jbrryhooves/sound-compass/sch/mic-test-board/manufacturing/mic_test_board_RevA.csv

Reference | Value | Datasheet | Footprint | Qty | DNP | EXCLUDE_FROM_BOM | Manufacturer | Part Number | Supplier | Supplier Number | Voltage
C1 C3 C5 C7 C9 C12 C15 C19 C24 C59-C64 C67 C69 C71 C73 C75 C79 C81 | 1uF | ~ | Capacitor_SMD:C_0603_1608Metric | 22 | -- mixed values -- |  | YAGEO | CC0603KRX7R7BB105 | Digi-Key | 311-1446-1-ND | 16V
C2 C4 C6 C8 C10 C11 C13 C14 C17 C21-C23 C25 C68 C70 C72 C74 C76 C78 C80 C82 C83 C201 C208-C211 | 0.1uF | ~ | Capacitor_SMD:C_0603_1608Metric | 27 |  |  | YAGEO | CC0603KRX7R7BB104 | Digi-Key | 311-1088-1-ND | 16V
C16 C77 | 10uF | ~ | Capacitor_SMD:C_0805_2012Metric | 2 |  |  | Samsung Electro-Mechanics | CL21B106KOQNNNE | Digi-Key | 1276-2872-1-ND | 16V
C18 C20 C26 C27 C29 C30 C33 C35 C36 C39 C41 C42 C45 C47 C48 C51 C53 C54 C57 C65 C66 C86 C88 C89 C92 C94 C95 C98 C100 C101 C104 C106 C107 C110 C112 C113 C116 C118 C119 C122 C124 C125 C128 C130 C131 C134 C186 C187 | 10nF | ~ | Capacitor_SMD:C_0603_1608Metric | 48 |  |  | KEMET | C0603C103M4RAC7867 | Digi-Key | 399-C0603C103M4RAC7867CT-ND | 16V
D1-D10 | LED_Small_Filled | ~ | LED_SMD:LED_0805_2012Metric | 10 |  |  | Lumex Opto/Components Inc. | SML-LX0805SRC-TR | Digi-Key | 67-2191-1-ND
D11 | SMBJ5340BE3/TR13 | https://www.microsemi.com/document-portal/doc_download/124875-lds-0246-2-datasheet | Diode_SMD:D_SMB | 1 |  |  | Microchip Technology | SMBJ5340BE3/TR13 | Digi-Key | 150-SMBJ5340BE3/TR13CT-ND | 6V
J1 J5 | -- mixed values -- | ~ | ~ | 2 |  |  | Sullins Connector Solutions | GEC36DFBN-M30 | Digi-Key | S2341E-36-ND
J3 | Conn_01x02 | ~ | Connector_PinHeader_2.54mm:PinHeader_1x02_P2.54mm_Vertical | 1
J4 | Conn_01x02 | ~ | TerminalBlock_Phoenix:TerminalBlock_Phoenix_MKDS-1,5-2_1x02_P5.00mm_Horizontal | 1 |  |  | Phoenix Contact | 1715022 | Digi-Key | 277-1258-ND
J6 | CN11.male | ~ | ~ | 1 |  |  | Sullins Connector Solutions | PPTC042LFBN-RC | Digi-Key | S7072-ND
J7-J9 J11 J13 J15 J17 J19 J21 J23 J25 J27 J29 J31 J33 J35 | Conn_01x05 | https://www.molex.com/pdm_docs/sd/530470510_sd.pdf | mic-test-board:Molex_PicoBlade_53047-0510_1x05_P1.25mm_Vertical | 16 |  |  | Molex | 0530470510 | Digi-Key | WM1734-ND
J10 J14 J16 J18 J20 J22 J24 J26 J28 J30 J32 J34 J36-J38 P1 | Mating pre-crimped connector, 300mm | https://www.literature.molex.com/SQLImages/kelmscott/Molex/PDF_Images/987651-5322.PDF | ~ | 16 |  |  | Molex | 0151340503 | Digi-Key | WM15263-ND
J12 | CN12.male | ~ | ~ | 1 |  |  | Sullins Connector Solutions | PPPC362LFBN-RC | Digi-Key | S7139-ND
R1 R40 | 49.9R | ~ | Resistor_SMD:R_0603_1608Metric | 2 |  |  | Panasonic Electronic Components | ERJ-3EKF49R9V | Digi-Key | P49.9HCT-ND
R2 R3 R8 R14 R20 R26-R28 R32 R35 R37-R39 R45 R53 R59 R65 R71 R77 R83 R89 R95 R101 R118-R120 R238 | 0R | ~ | Resistor_SMD:R_0603_1608Metric | 27 | -- mixed values -- |  | Stackpole Electronics Inc | RMCF0603ZT0R00 | Digi-Key | RMCF0603ZT0R00CT-ND
R4 R33 R135-R142 | 470R | ~ | Resistor_SMD:R_0603_1608Metric | 10 |  |  | YAGEO | RC0603JR-07470RL | Digi-Key | 311-470GRCT-ND
R5-R7 R9 R12 R15 R18 R21 R24 R30 R43 R46 R49 R54 R57 R60 R63 R66 R69 R72 R75 R78 R81 R84 R87 R90 R93 R96 R99 R102 R105 R223 | 33R | ~ | Resistor_SMD:R_0603_1608Metric | 32 |  |  | Vishay Dale | CRCW060333R0FKEAC | Digi-Key | 541-3988-1-ND
R10 R11 R13 R29 R31 R34 R36 | 100k | ~ | Resistor_SMD:R_0603_1608Metric | 7 | -- mixed values -- |  | YAGEO | RC0603FR-07100KL | Digi-Key | 311-100KHRCT-ND
SW1 SW2 | SW_Push | ~ | Button_Switch_SMD:SW_SPST_CK_RS282G05A3 | 2 |  |  | C&K | RS-282G05A3-SM RT | Digi-Key | CKN10384CT-ND
TP118-TP121 | -- mixed values -- | ~ | TestPoint:TestPoint_Keystone_5019_Minature | 4 |  |  | Keystone Electronics | 5019 | Digi-Key | 36-5019CT-ND
U1 | LMK1C1102 | https://www.ti.com/lit/ds/symlink/lmk1c1104.pdf | Package_SON:WSON-8-1EP_2x2mm_P0.5mm_EP0.9x1.6mm | 1 |  |  | Texas Instruments | LMK1C1102DQFR | Digi-Key | 296-LMK1C1102DQFRCT-ND
U2 U6 | AD7768BSTZ | https://www.analog.com/media/en/technical-documentation/data-sheets/ad7768-7768-4.pdf | Package_QFP:LQFP-64_10x10mm_P0.5mm | 2 |  |  | Analog Devices Inc. | AD7768BSTZ | Digi-Key | 505-AD7768BSTZ-ND
U3 | MAX6070BAUT33+T | https://www.analog.com/media/en/technical-documentation/data-sheets/max6070-max6071.pdf | Package_TO_SOT_SMD:SOT-23-6 | 1 |  |  | Analog Devices Inc./Maxim Integrated | MAX6070BAUT33+T | Digi-Key | MAX6070BAUT33+TCT-ND
U22 | LP5912-5.0DRV | http://www.ti.com/lit/ds/symlink/lp5912.pdf | Package_SON:WSON-6-1EP_2x2mm_P0.65mm_EP1x1.6mm_ThermalVias | 1 |  |  | Texas Instruments | LP5912-5.0DRVR | Digi-Key | 296-53182-1-ND
U23 U24 | LP5912-3.3DRV | http://www.ti.com/lit/ds/symlink/lp5912.pdf | Package_SON:WSON-6-1EP_2x2mm_P0.65mm_EP1x1.6mm_ThermalVias | 2 | -- mixed values -- |  | -- mixed values -- | LP5912-3.3DRVR | Digi-Key | 296-47214-1-ND
U34 | SN74LVC126ARGYR | https://www.ti.com/lit/ds/symlink/sn74lvc126a.pdf | mic-test-board:IC_SN74AUC08RGYRG4 | 1 |  |  | Texas Instruments | SN74LVC126ARGYR | Digi-Key | 296-13962-1-ND
X1 | KC3225Z32.7680C1KX00 | https://mm.digikey.com/Volume0/opasdata/d220001/medias/docus/204/KC3225Z_Series_Spec_Prelim.pdf | Oscillator:Oscillator_SMD_SeikoEpson_SG210-4Pin_2.5x2.0mm | 1 |  |  | KYOCERA AVX | KC3225Z32.7680C1KX00 | Digi-Key | 478-KC3225Z32.7680C1KX00CT-ND
