jbrryhooves/sound-compass/calc/TestPCBCalcs.xlsx

ADC
Preamp LP filter
Common mode filter
R | 33
C | 4.7e-08
Fc | 102614.4056 | Hz
R | 4000
C | 4.7e-10
Fc | 84656.88462 | Hz
Input differential 1st order HP filter
R | 200000 | Ohm | Input impedance of the THS4531AIRUNR opamp
C | 1e-07 | F | Input DC blocking cap
Fc | 7.957747155 | Hz
