jbrryhooves/sound-compass/sch/mic-test-board/mic-test-pcb 3D v250321.pdf

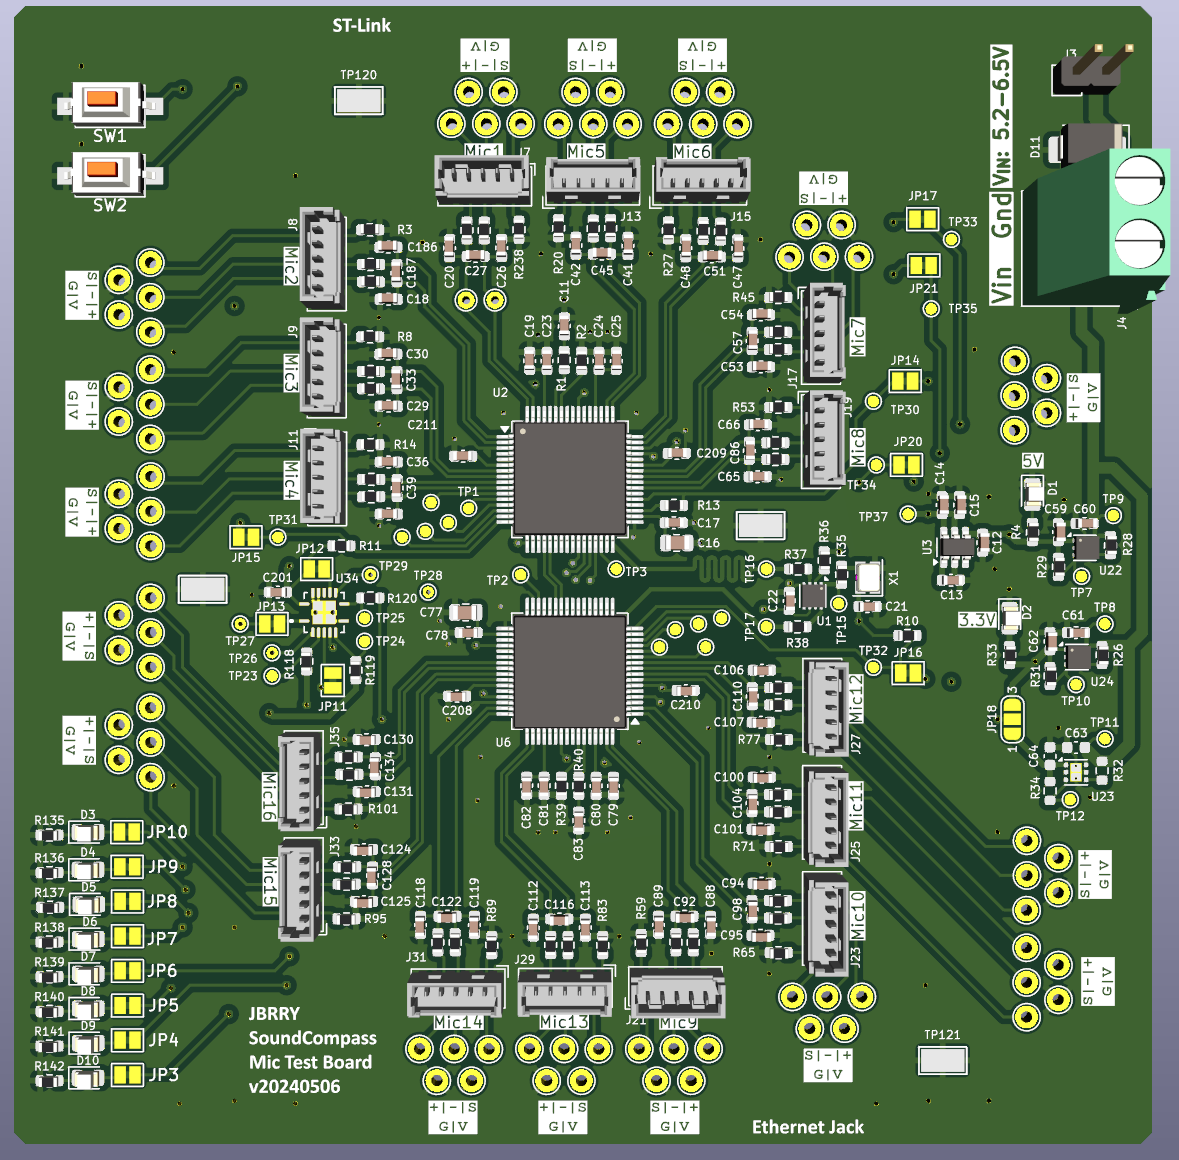
[picture p1: figure]

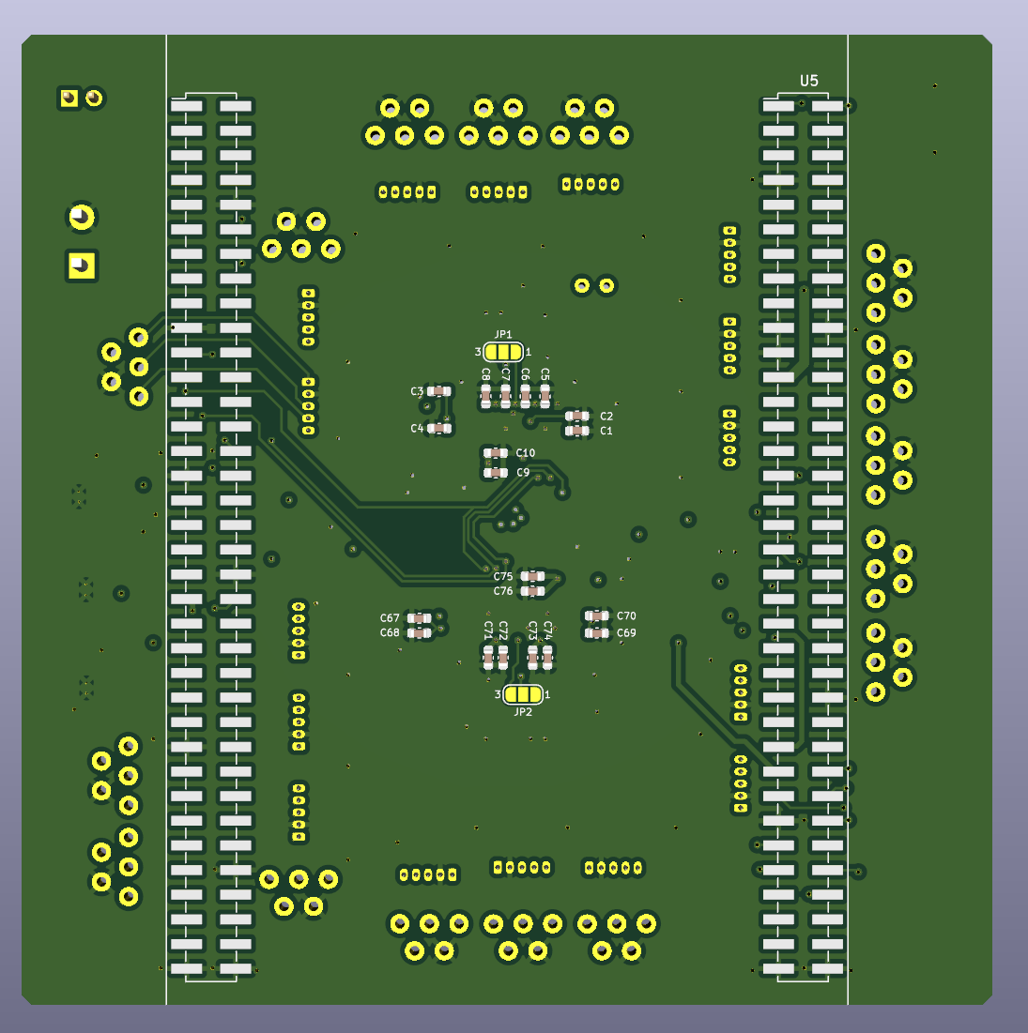
[picture p2: figure]

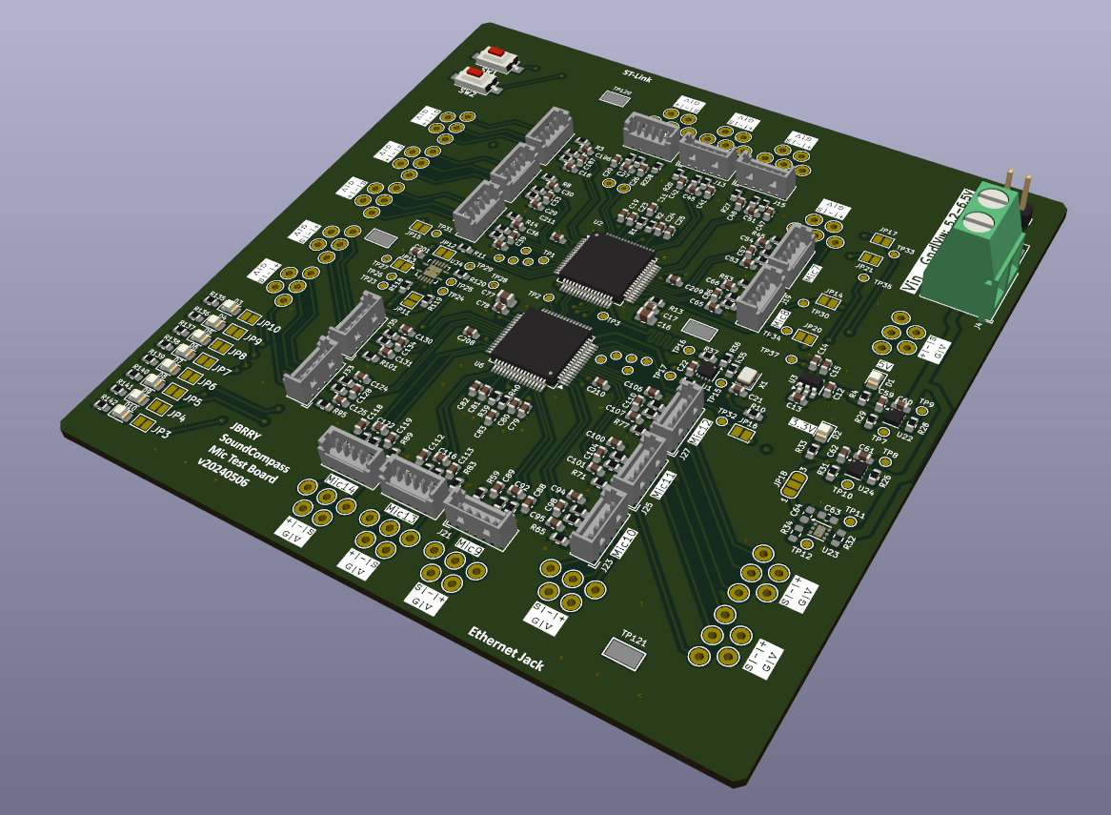
[picture p3: figure]
