jbrryhooves/sound-compass/sch/mic-test-board/mic-test-pcb v250321.pdf

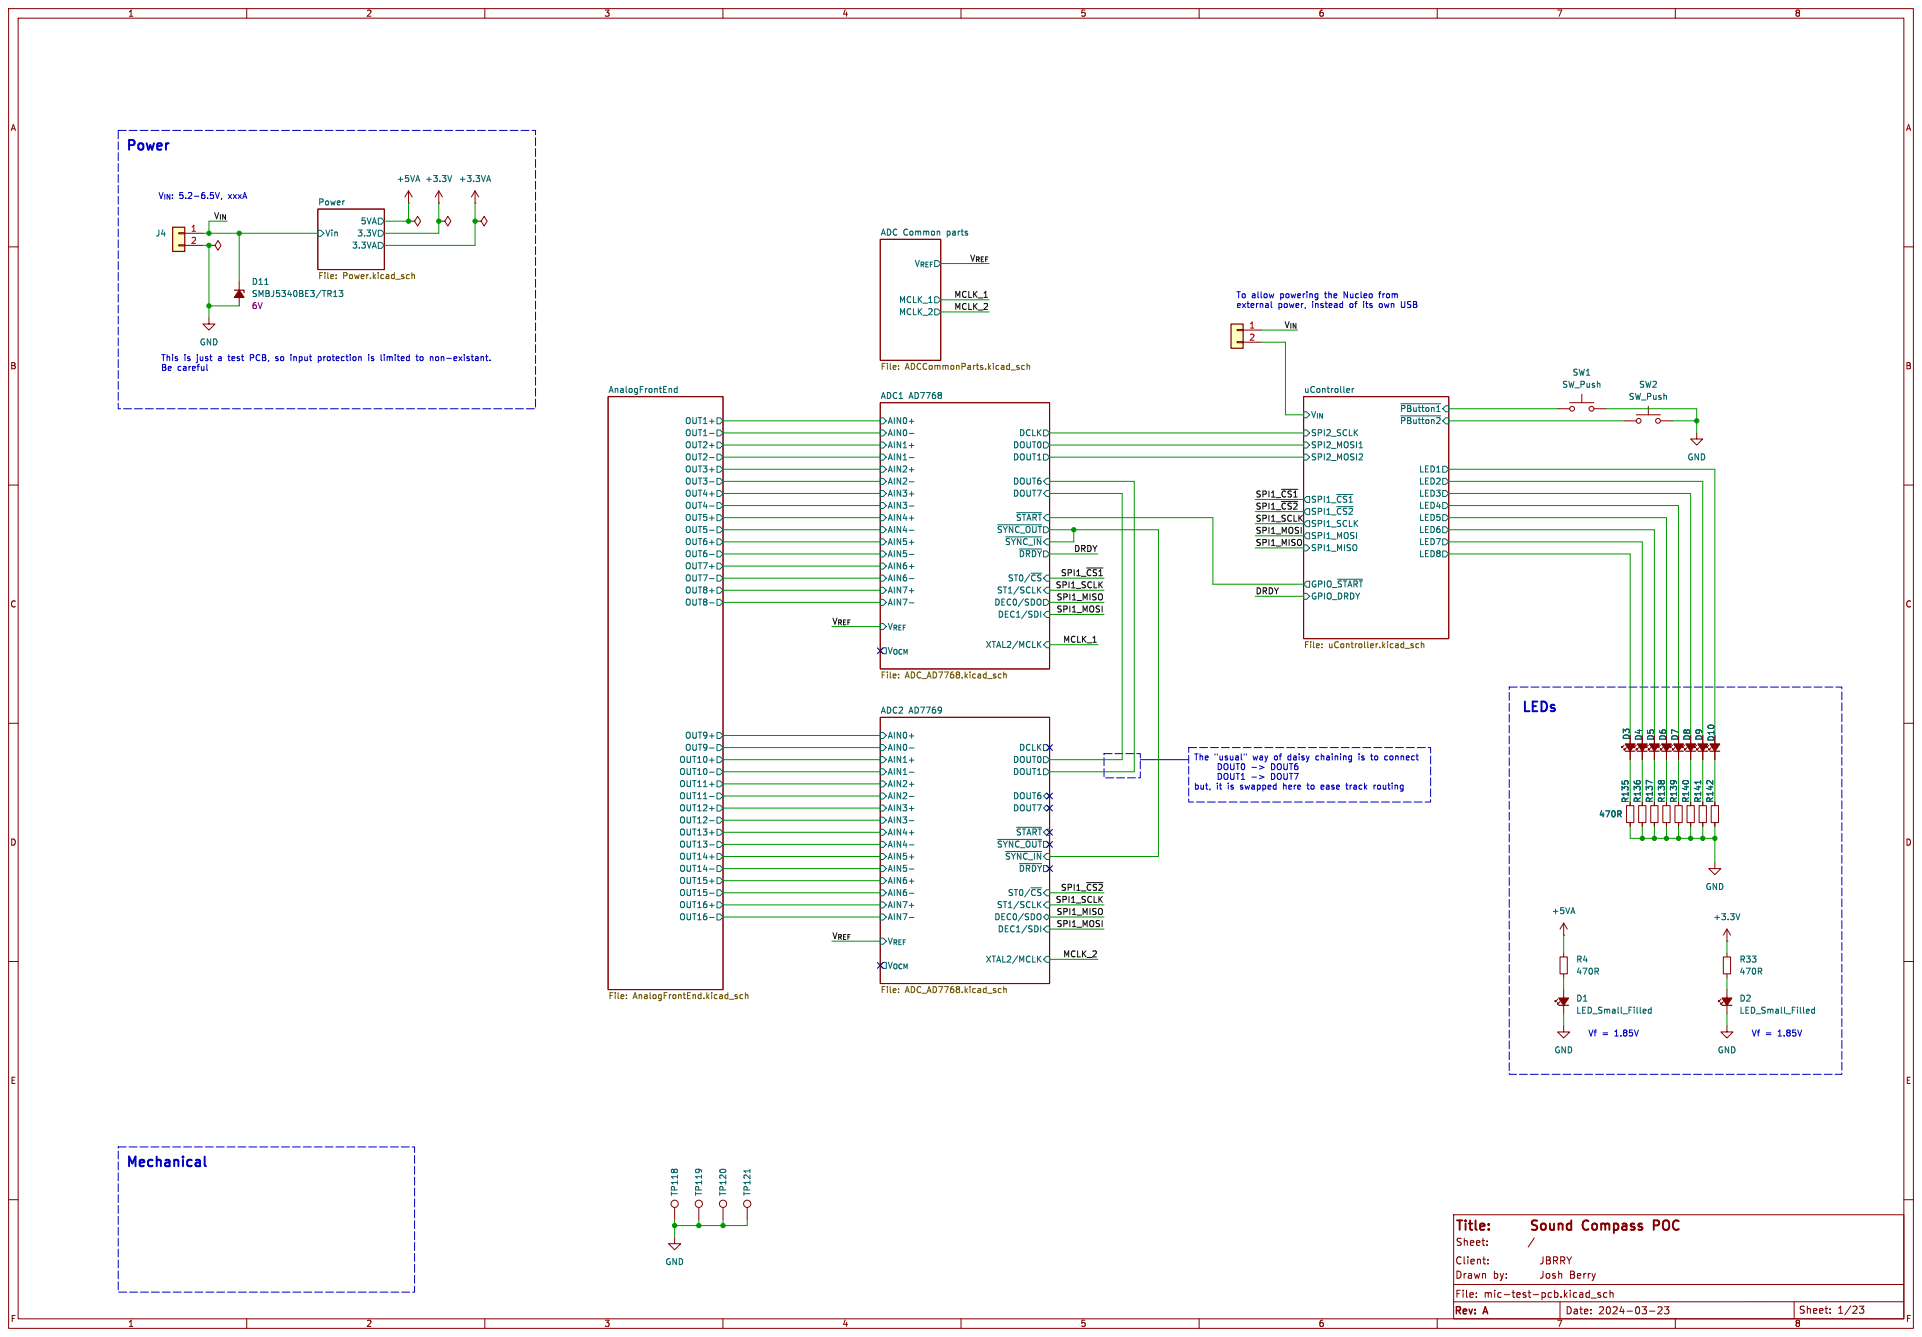
[picture p4: page 1]

To allow powering the Nucleo from

~{DRDY} DOUT1 DCLK DOUT0 DOUT6 DOUT7 ST0/~{CS} ST1/SCLK DEC0/SDO

DEC1/SDI V_{OCM} ADC2 AD7769 File: ADC_AD7768.kicad_sch OUT15+ OUT15- OUT16+ OUT16- OUT11- OUT11+ OUT12- OUT10- OUT12+ OUT14- OUT14+ OUT13- OUT13+ OUT10+ OUT9+ OUT9- OUT1+ OUT1- OUT4+ OUT4- OUT3+ OUT3- OUT7+ OUT5- OUT5+ OUT6+ OUT6- OUT8+ OUT7- OUT8- OUT2+ OUT2- AnalogFrontEnd

but, it is swapped here to ease track routing

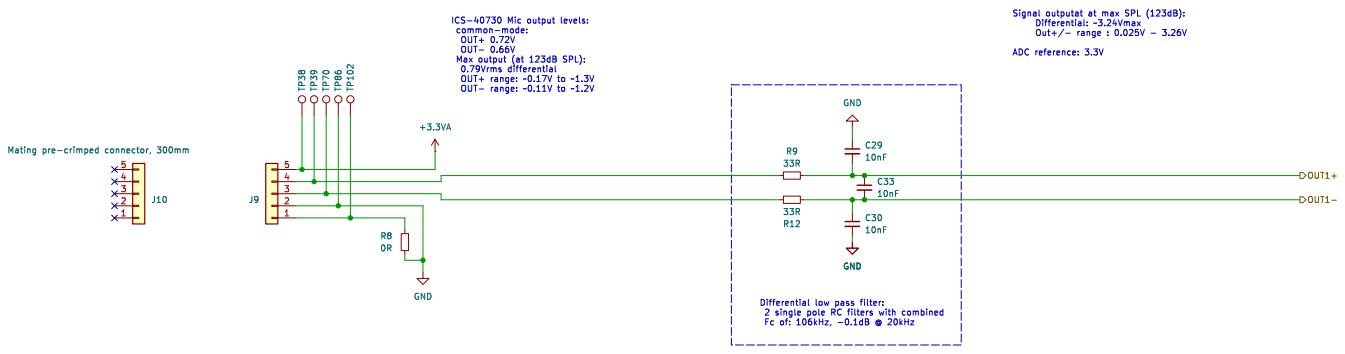
[picture p5: page 2]

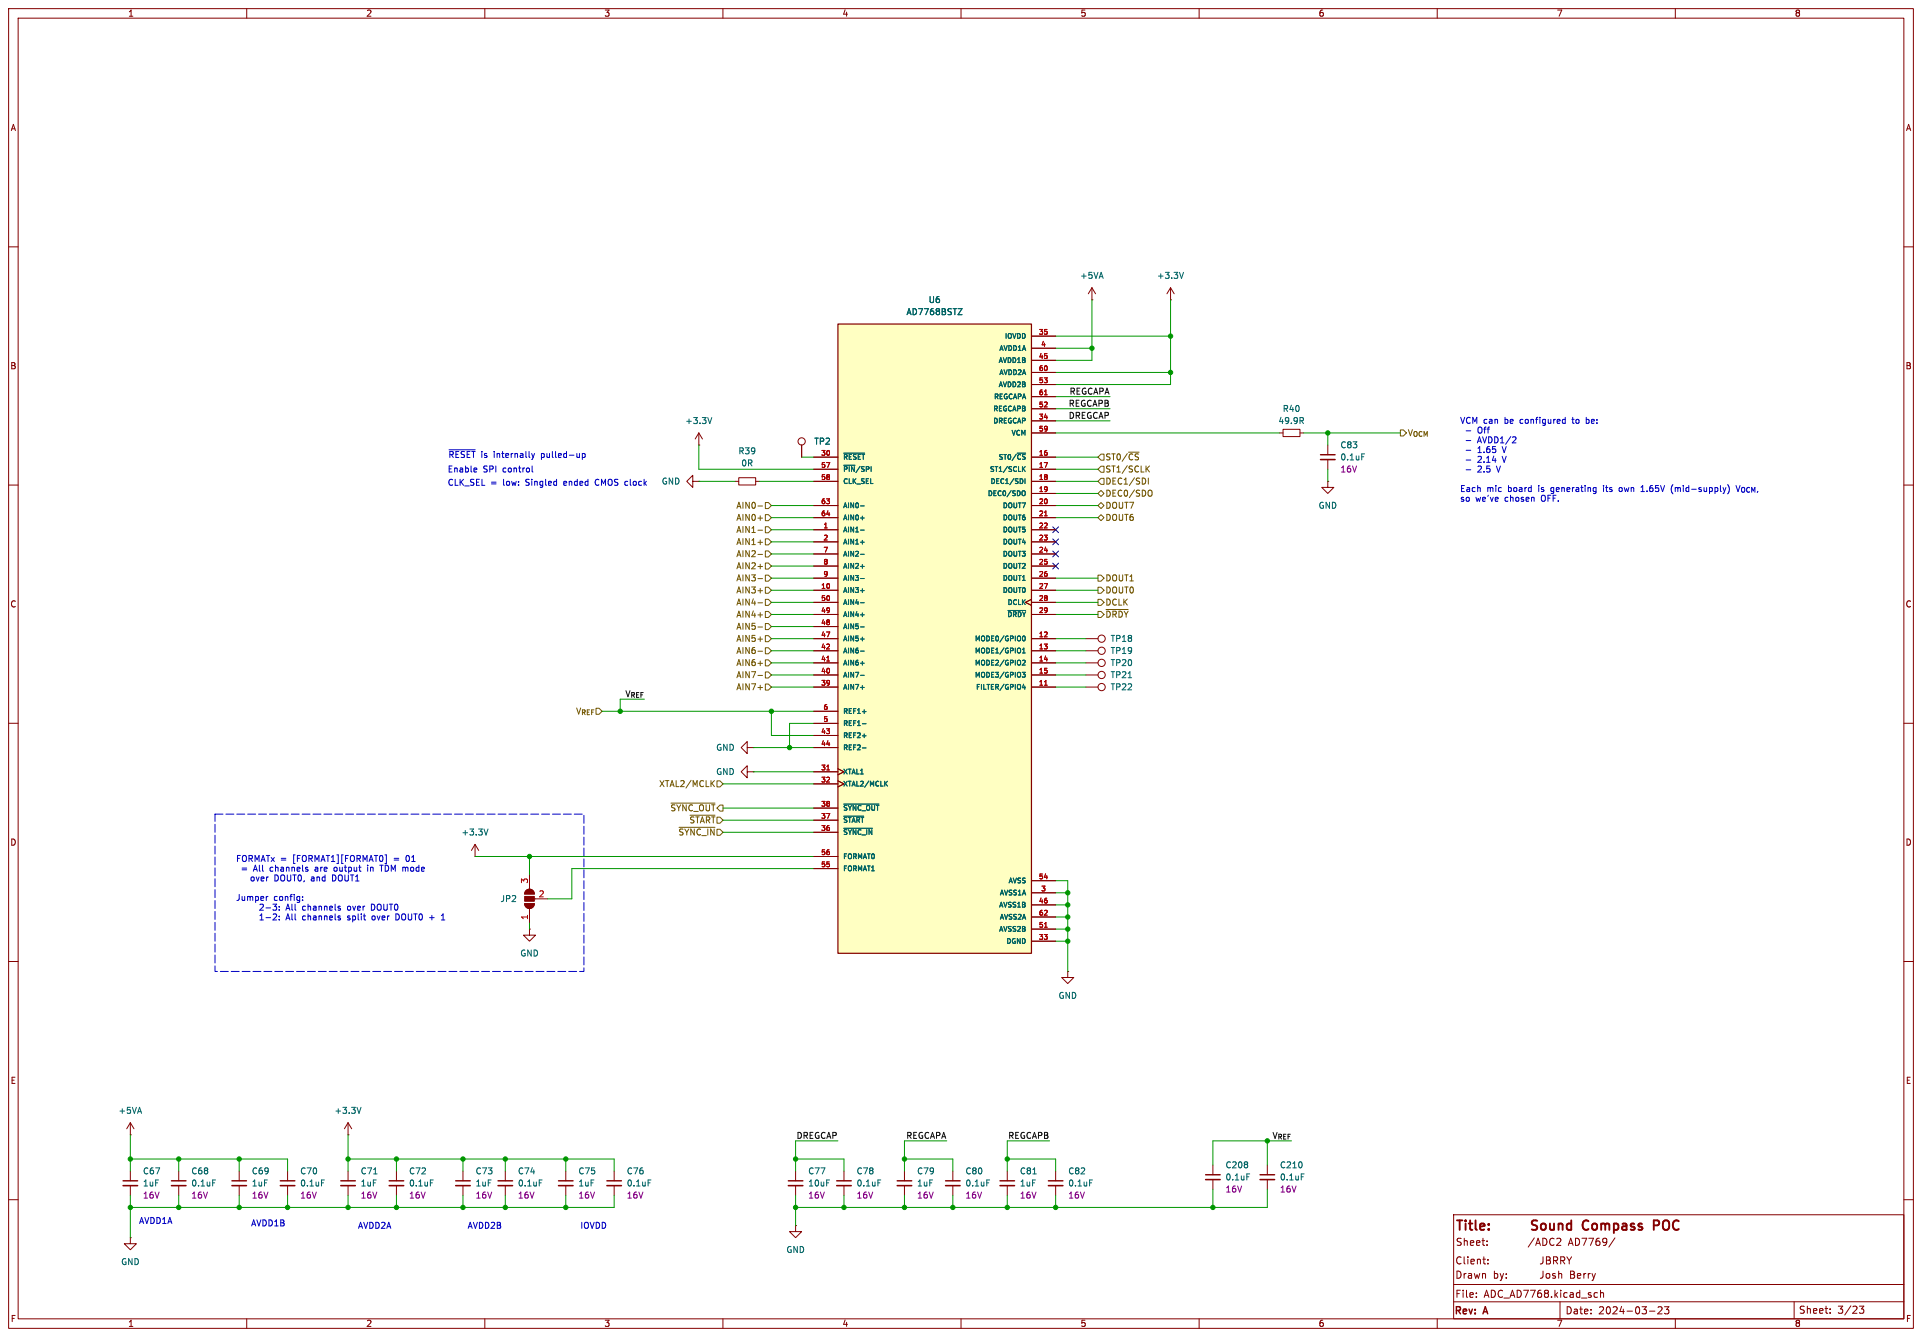
[picture p6: page 3]

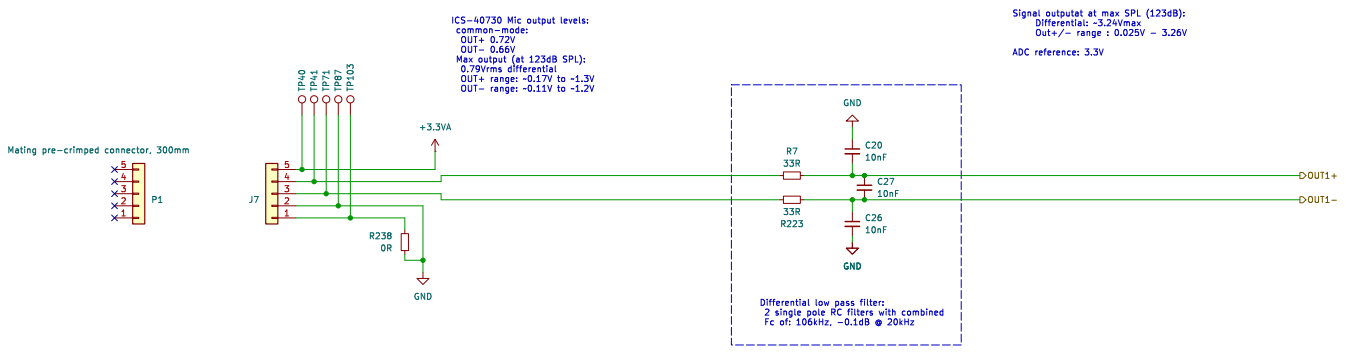
[picture p7: page 4]

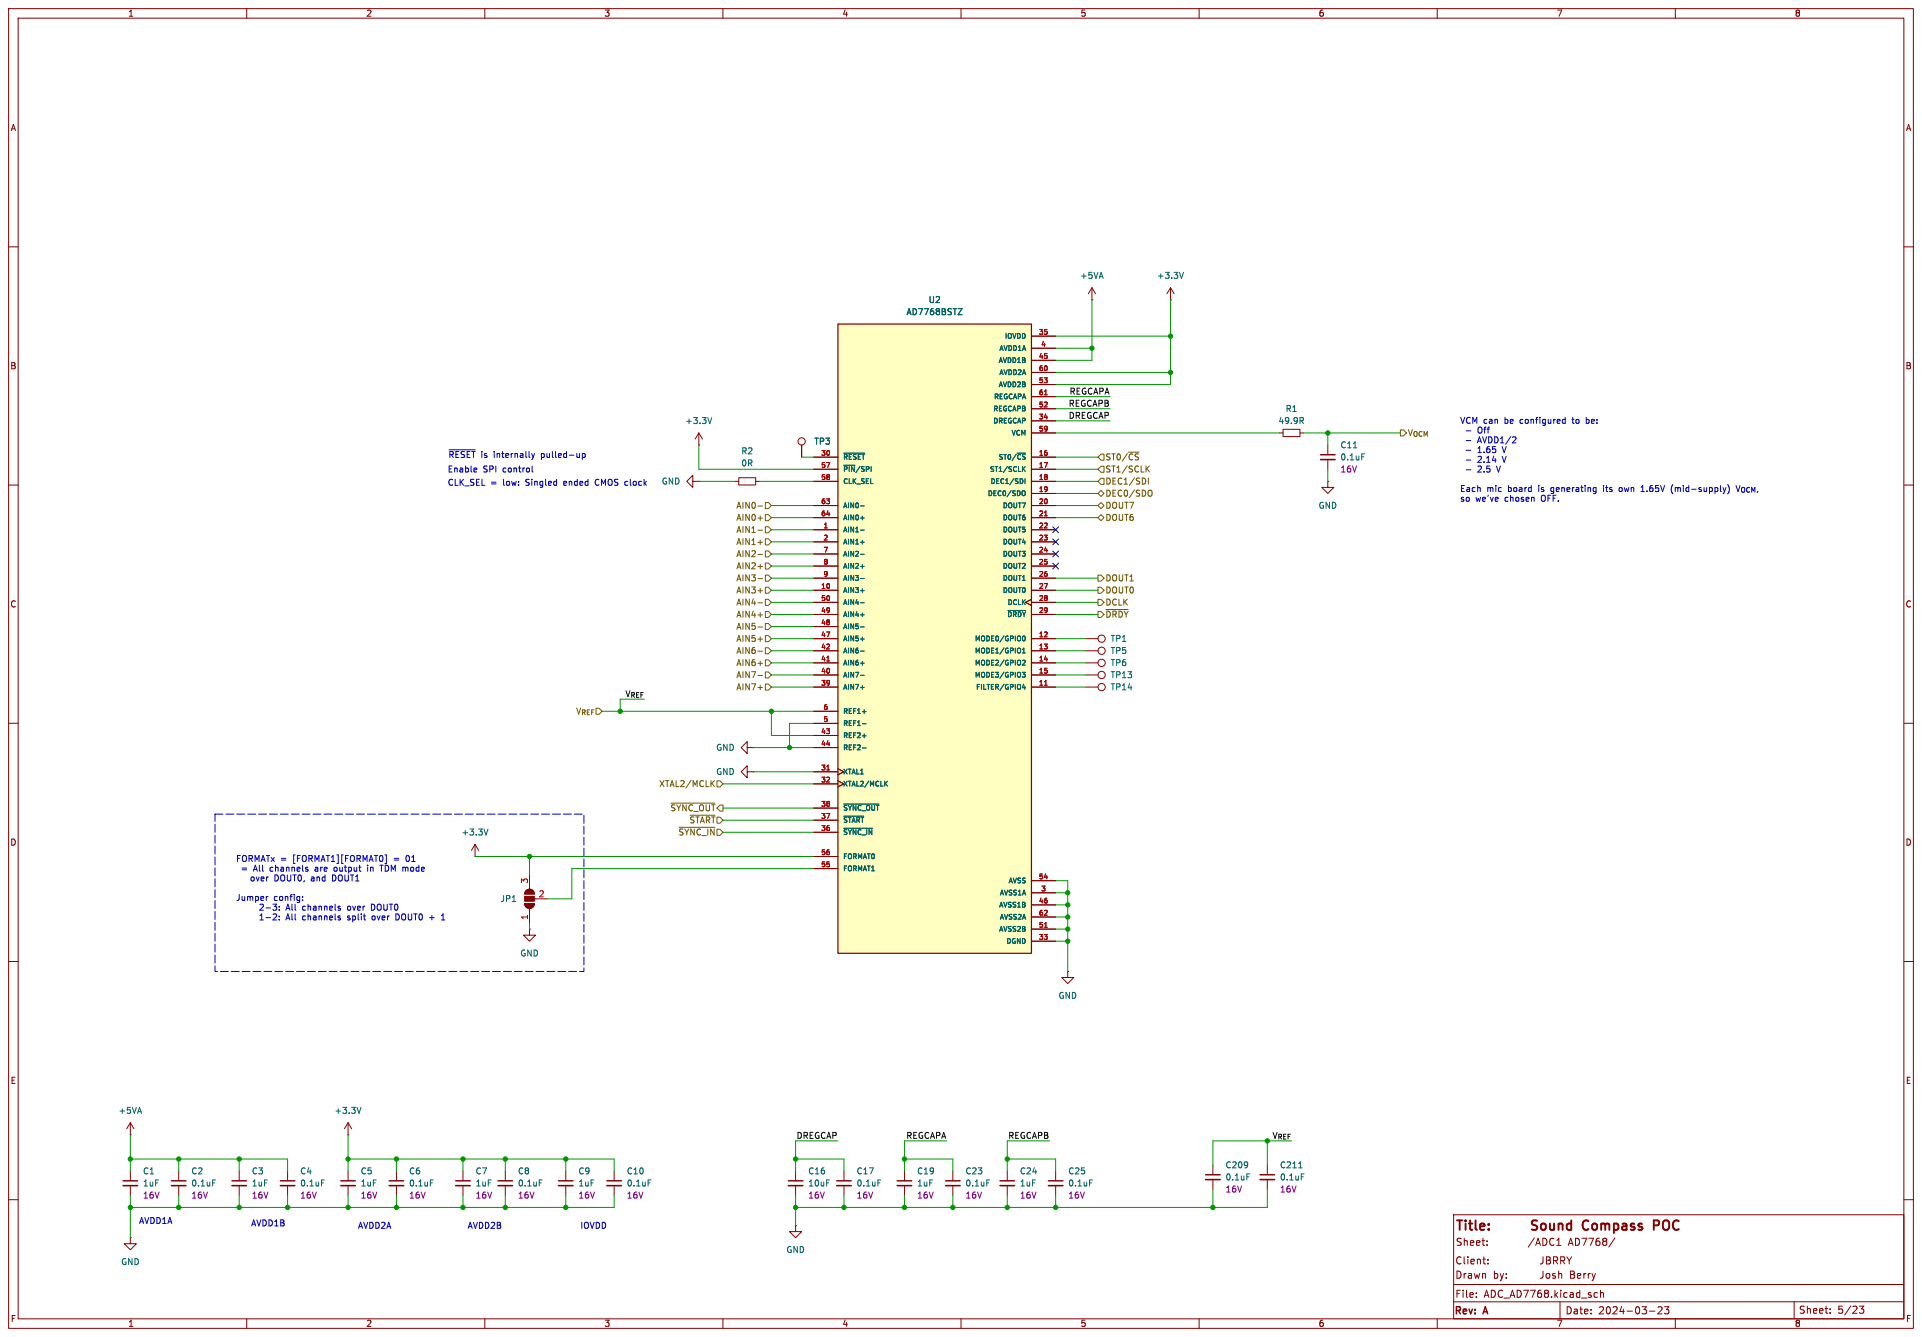
[picture p8: page 5]

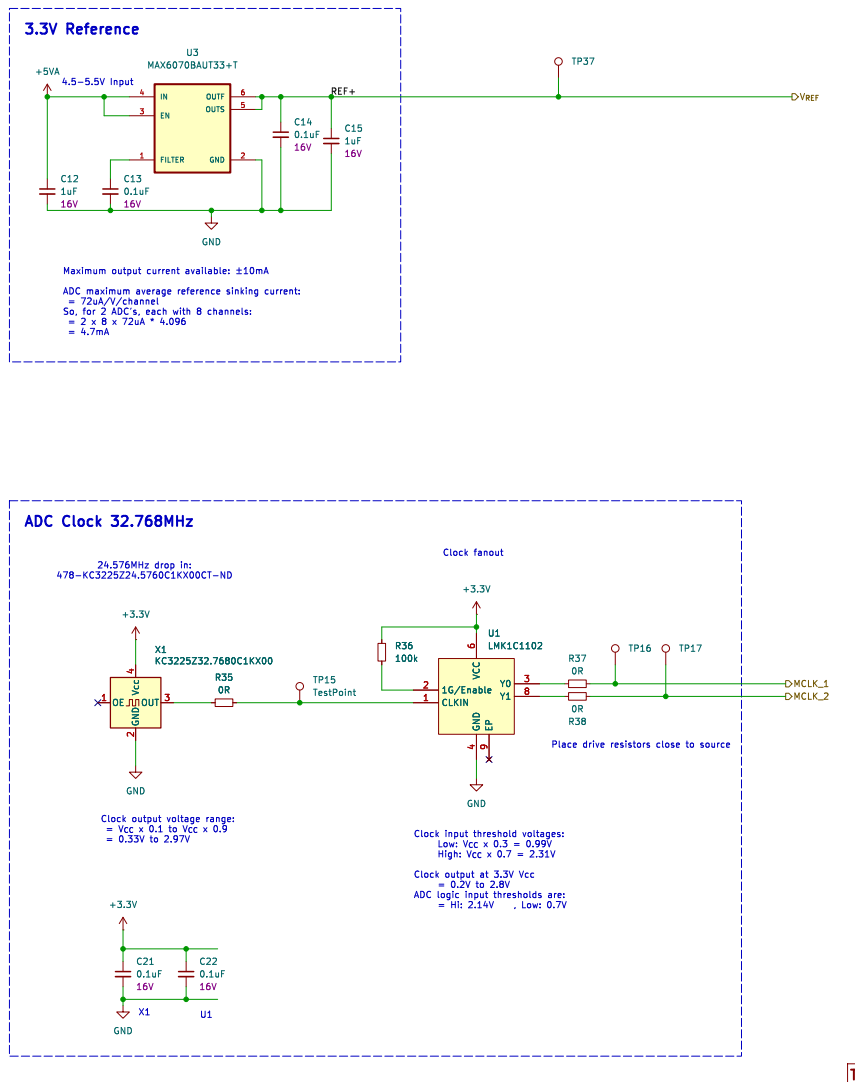
[picture p9: page 6]

Clock output voltage range: = V_{CC} x 0.1 to V_{CC} x 0.9 = 0.33V to 2.97V

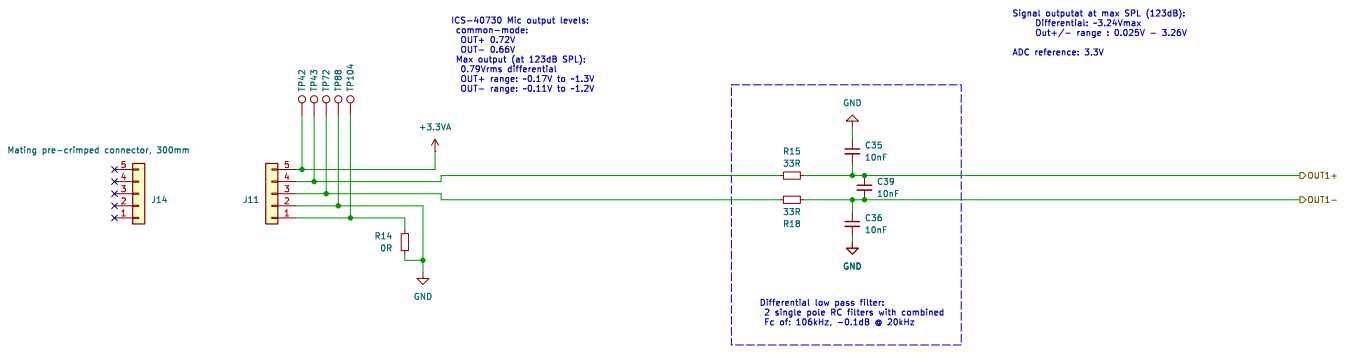
[picture p10: page 7]

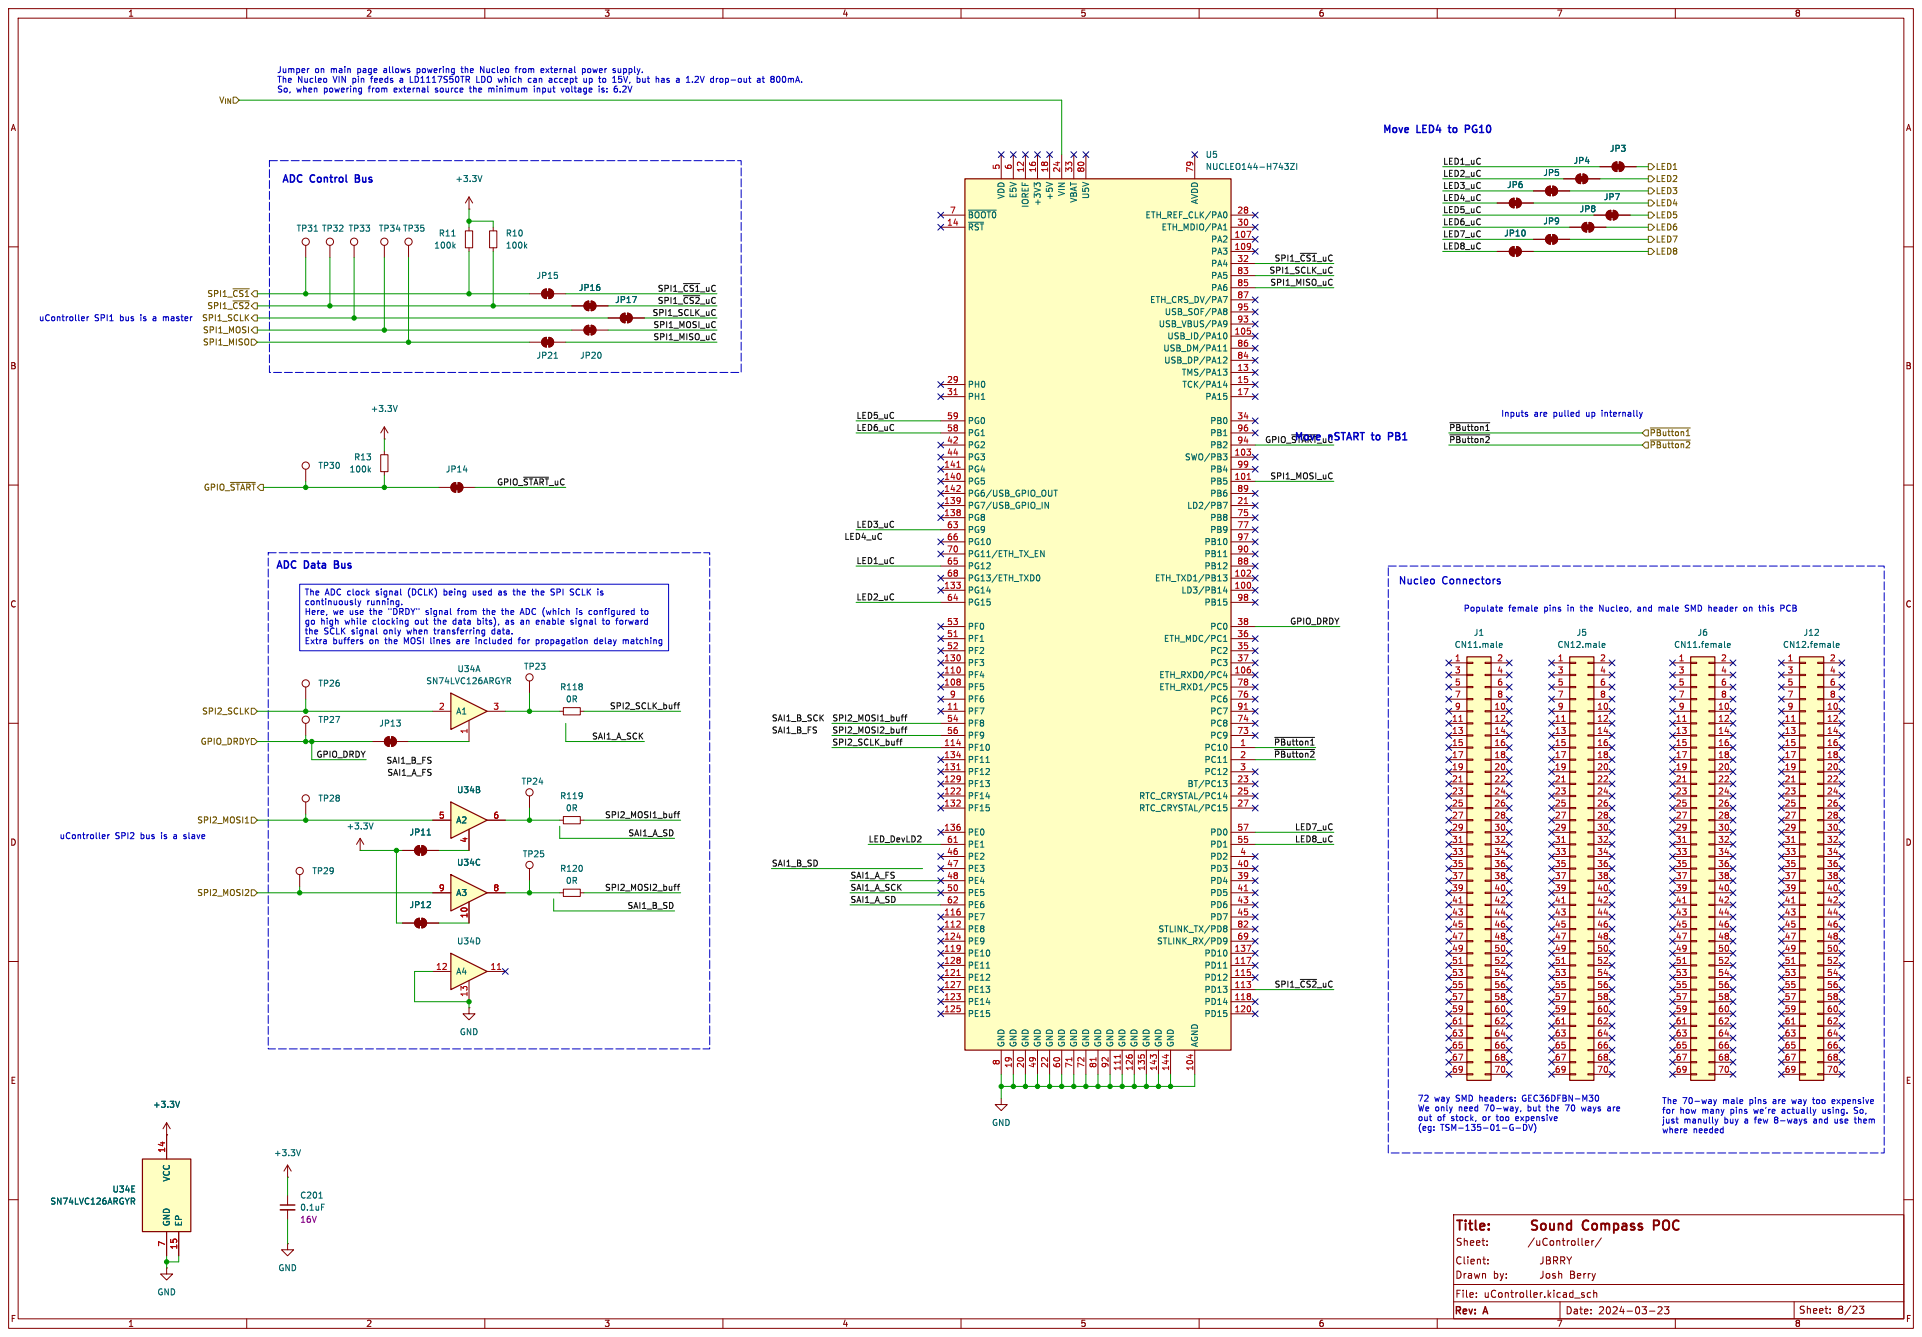
[picture p11: page 8]

Inputs are pulled up internally

The ADC clock signal (DCLK) being used as the the SPI SCLK is

out of stock, or too expensive
(eg: TSM-135-01-G-DV)

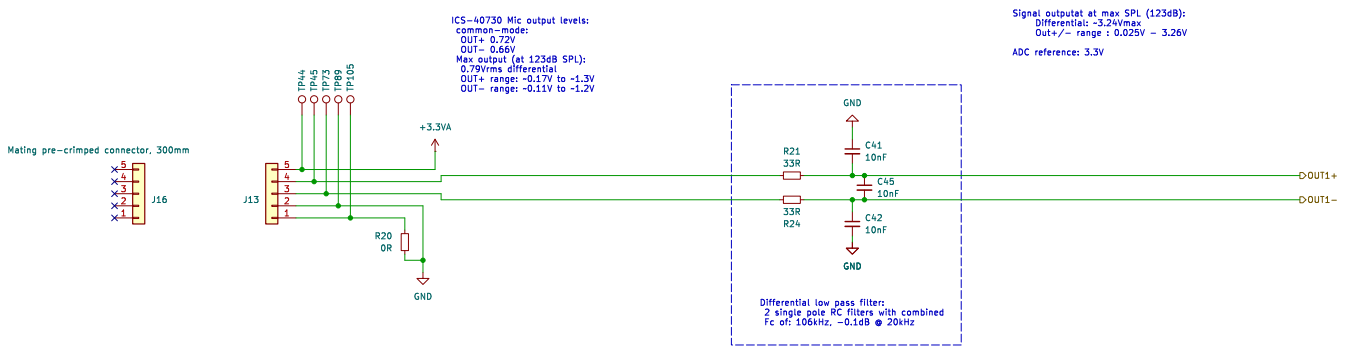
[picture p12: page 9]

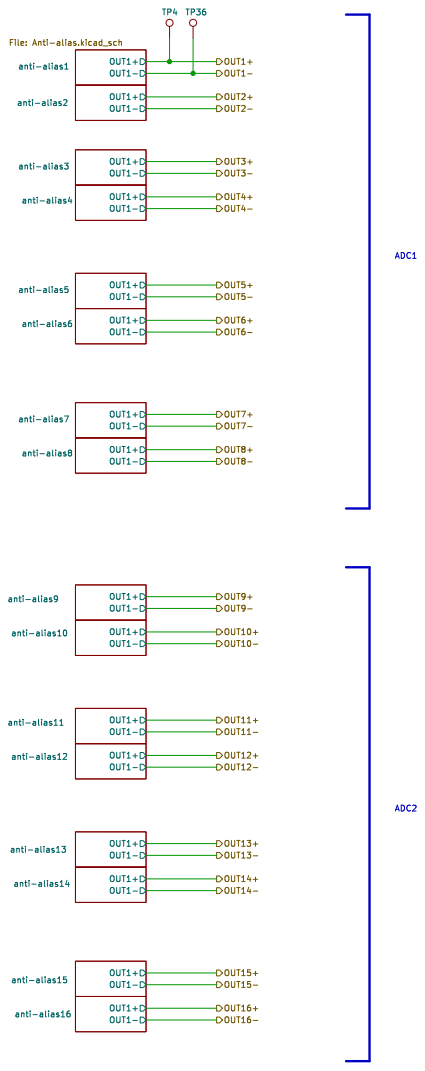
[picture p13: page 10]

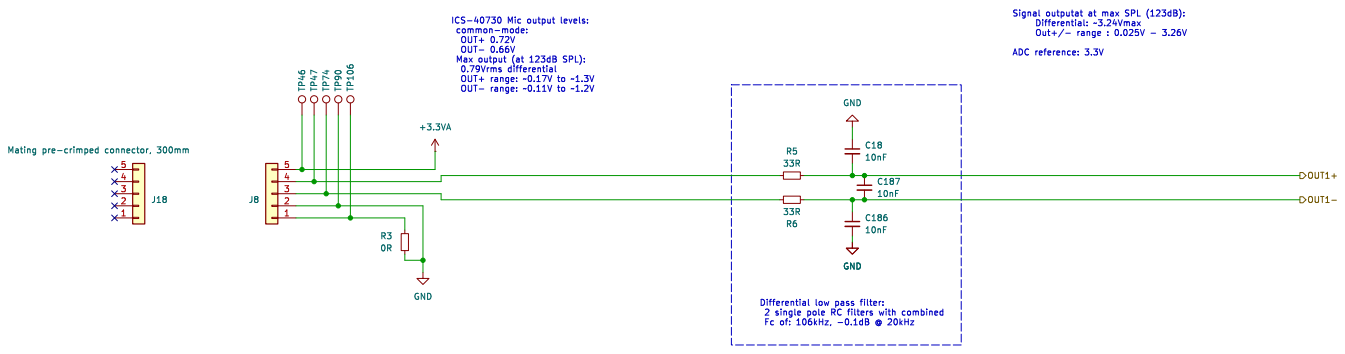
[picture p14: page 11]

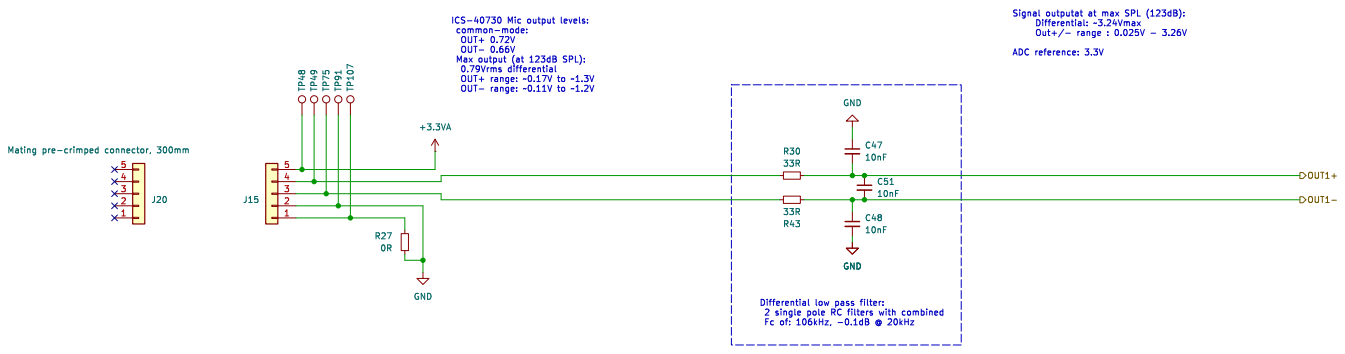
[picture p15: page 12]

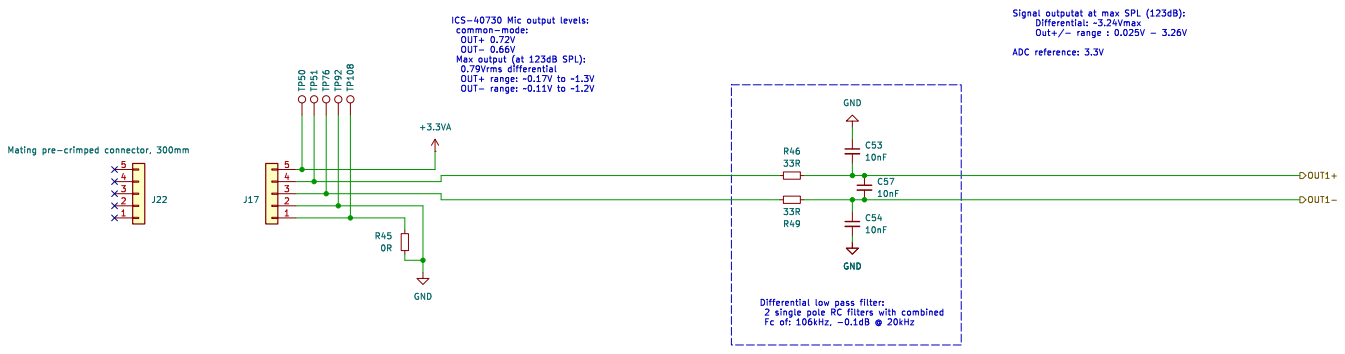
[picture p16: page 13]

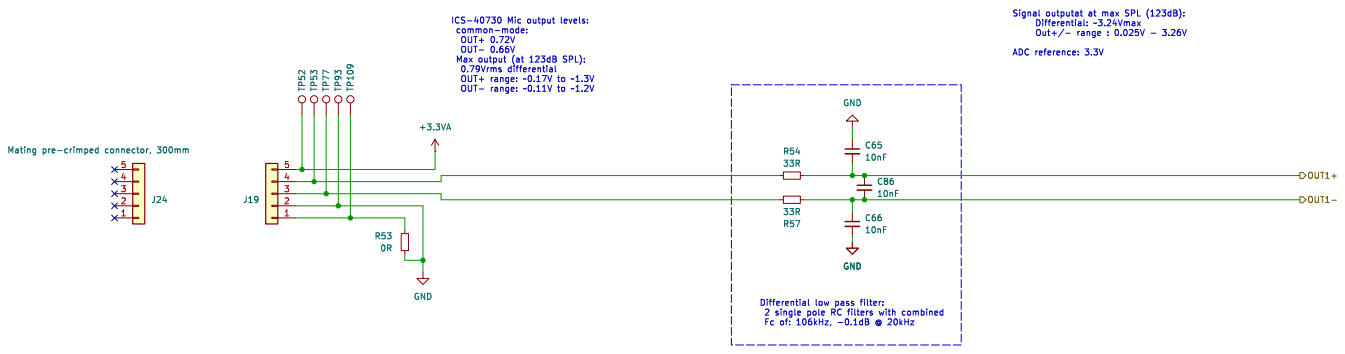
[picture p17: page 14]

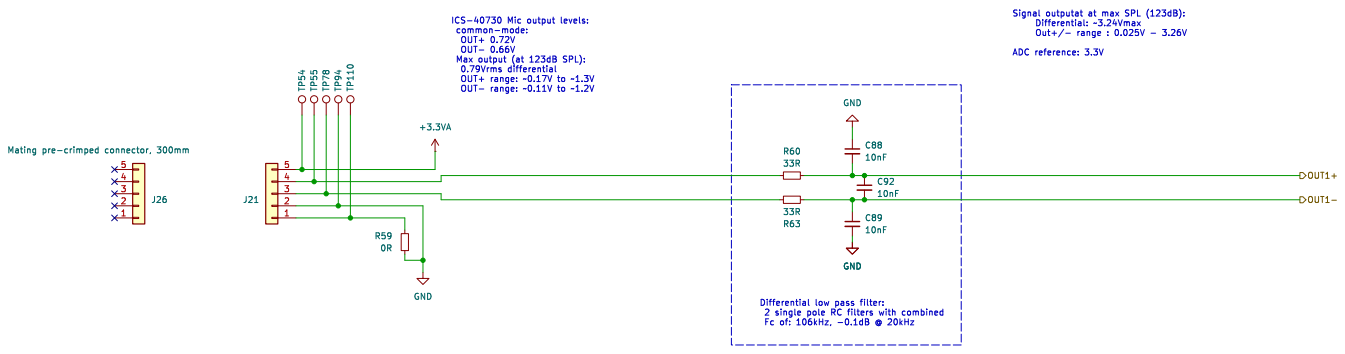
[picture p18: page 15]

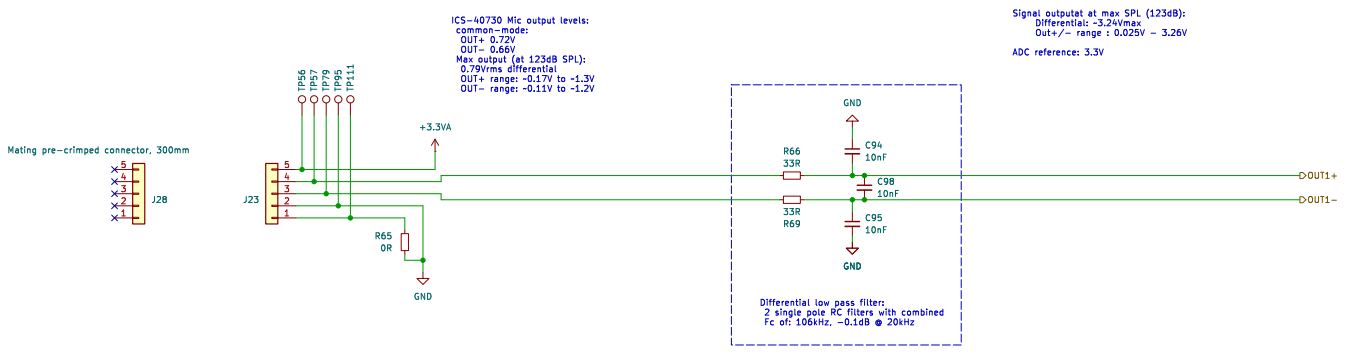
[picture p19: page 16]

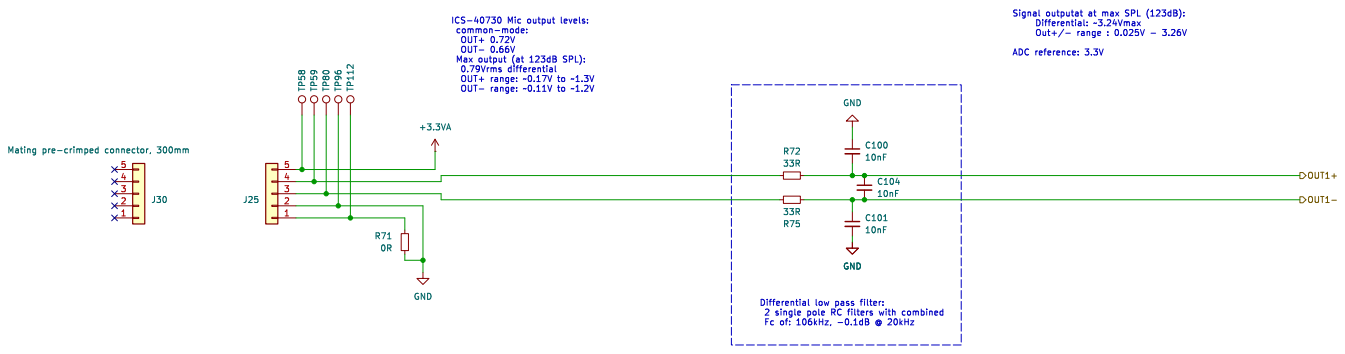
[picture p20: page 17]

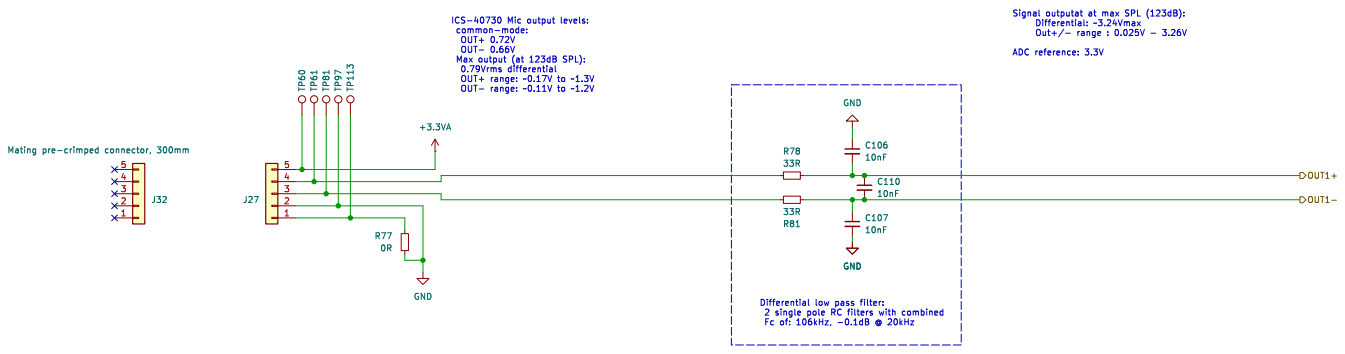
[picture p21: page 18]

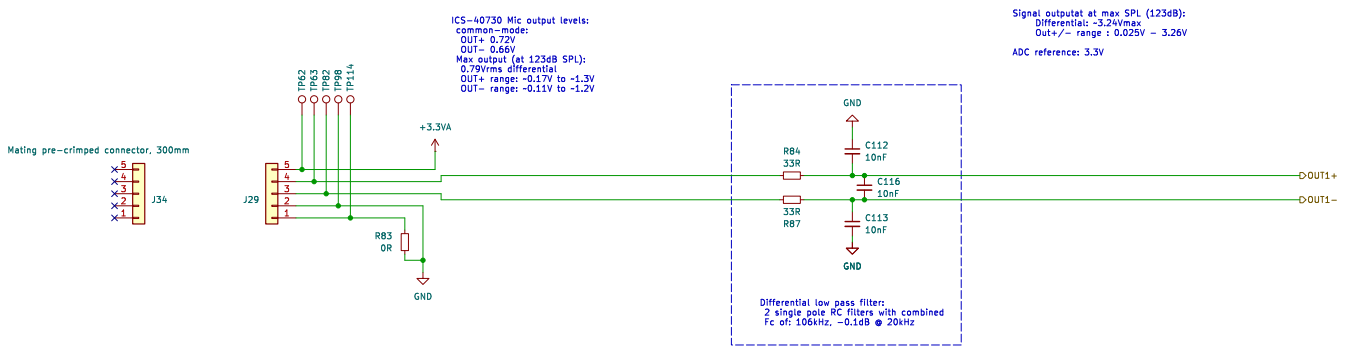
[picture p22: page 19]

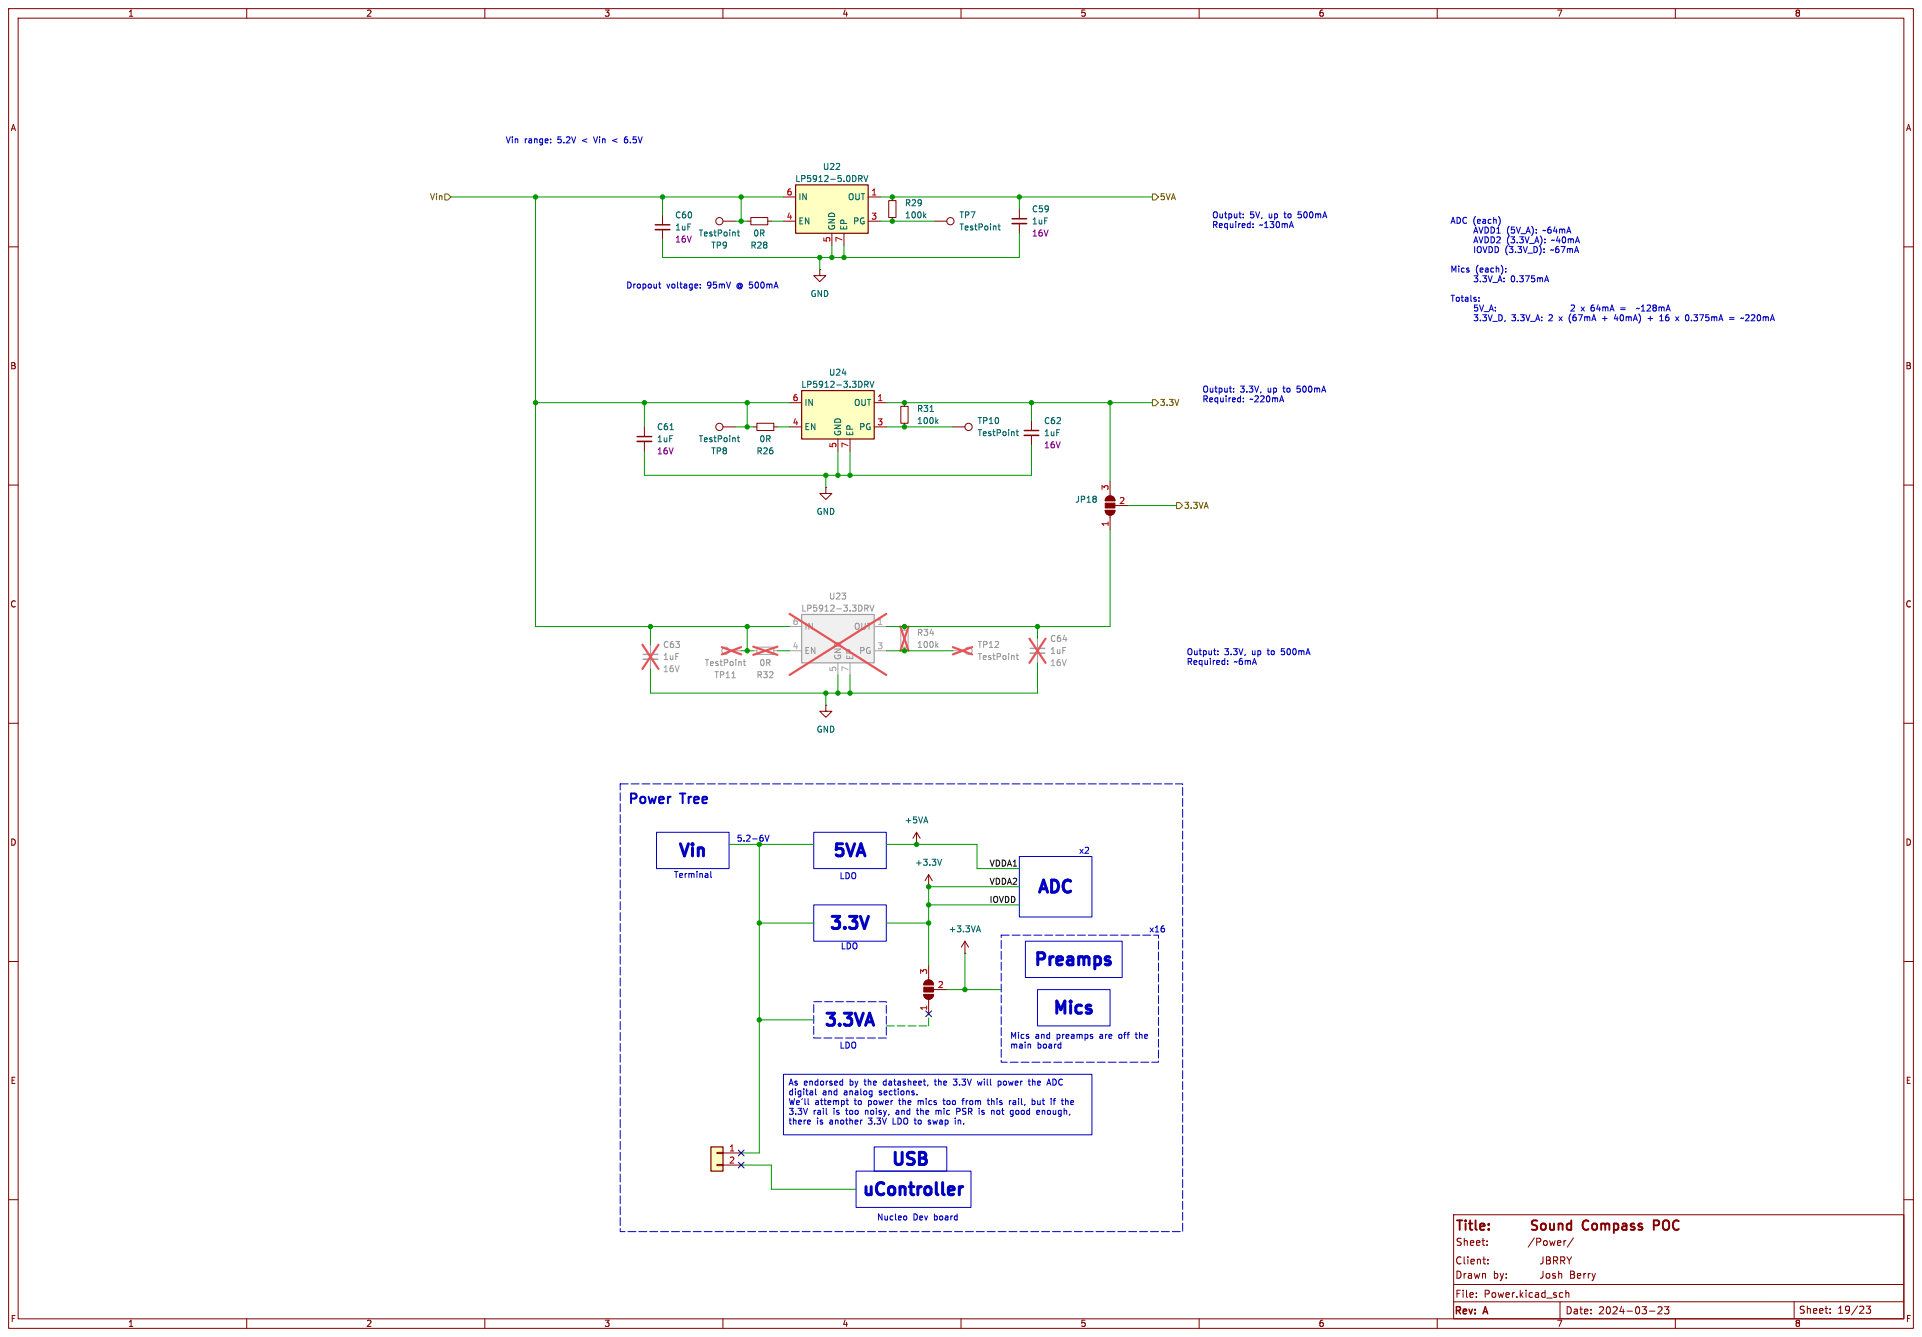
[picture p23: page 20]

Output: 3.3V, up to 500mA Required: ~6mA

there is another 3.3V LDO to swap in. 3.3V

x16 Mics and preamps are off the main board
Preamps

3.3V rail is too noisy, and the mic PSR is not good enough,

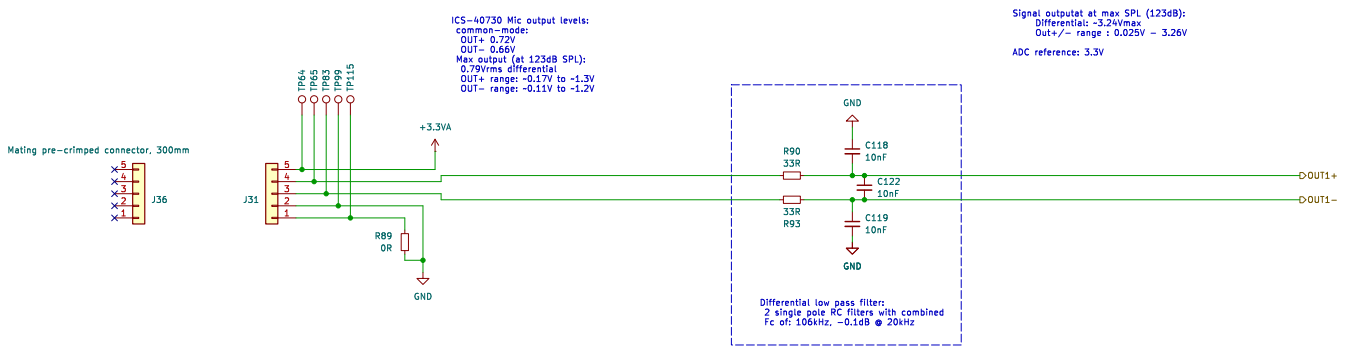
[picture p24: page 21]

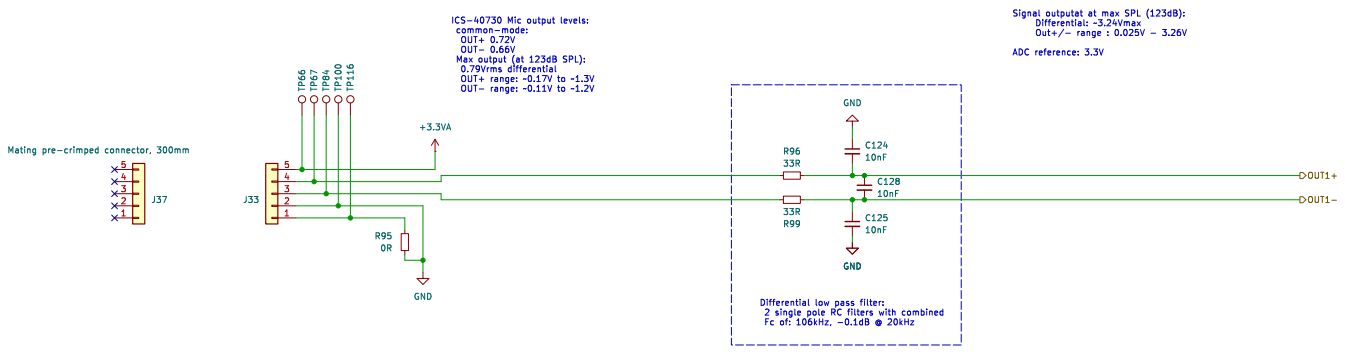
[picture p25: page 22]

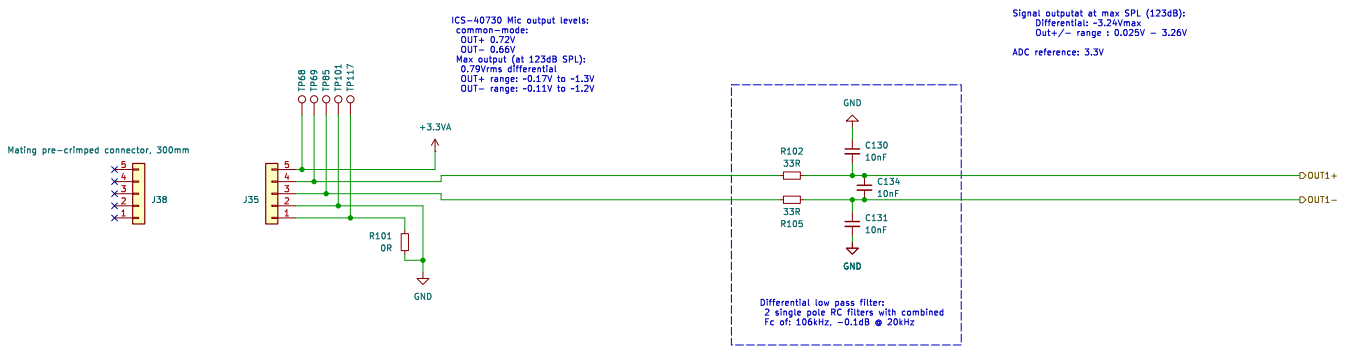
[picture p26: page 23]
