jbrryhooves/sound-compass/doc/System Block Diagram v250321.drawio.pdf

## QuadCore A53, Linux

## audioProcessor

## SoundCompass

::IMessageBusClient

beamResult

audioProcessor::app

- create thread pool
- create ::audioProcessor
- create listener sockets

main()

- parse CLI args
- create ::app
- call app.run()
- entry point of the application
- parse CLI args
- start the app
- wait for exit signal
- listen for messages over the message bus (eg. NNG, ZMQ)
- push jobs to ::beamProcessor via a threadpool
- receive results from ::beamProcessor
- send result messages over the message bus
- responsible for processing the incoming mic signals passed in from the ::app
- performs the beam steering and 1/3 octave band filtering

audioFrame

::SoundCompass

- main Sound Compass application
- passes mic signals to
audioProcessor
- saves results to db

audioProcessor::beamProcessor

- Main application
- rust
- Processing audio packets
- C++

channel

IMicrophoneReader

Ethernet

STM32H7

Buffer SPI | x16 | Buffer

Filtering?

Ethernet

GPIO/UART

- Reads audio from mics
and pushes it to the main
app

## Database

- System configuration
- Timeseries
- Candidates: TimescaleDB

## WebUI

- View data
- Control SoundCompass application
- View edit config
- Rust/Go/C#

::IMessageBusClient

onProcessedResult

pull socket | push socket

mic signal messages
pushed to audioProcessor

processed results pulled
from audioProcessor

RPC or req/rep
socket | WebUI interface

processed results pulled
from audioProcessor

mic signals

::IMessageBroker

::ProcessingStage

::ProcessingStage

nSYNC signal drives the sample rate and is attached to a timer
nDRDY goes low when a conversion result is ready to be read

UART/
GPIO
ADC (https://www.ti.com/lit/ds/symlink/ads1178.pdf) | SCLK
ADS1178 (https://www.ti.com/lit/ds/symlink/ads1178.pdf)

Mic 1

ADC
ADS1178 (https://www.ti.com/lit/ds/symlink/ads1178.pdf)

Mic 8

Mic 9

Mic 16

MEMS mics with
differential output

Buffering, anti-aliasing

MOSI

MISO

nSYNC

nDRDY

CLK
27MHz | MCO

A fCLK of 27MHz allows for a maximum data rate of 52kHz/channel

SPI SCLK and the ADC clock (fCLK) need to be of fSCLK/fCLK ratios of 1/1, 1/2, 1/4, or 1/8, etc

ADC's in daisy chained mode

DIN

DOUT1 (https://www.ti.com/lit/ds/symlink/ads1178.pdf)

ADC
AD7768 (https://www.analog.com/media/en/technical-documentation/data-sheets/ad7768-7768-4.pdf)

Mic 1

Mic 8

DOUT6 (https://www.analog.com/media/en/technical-documentation/data-sheets/ad7768-7768-4.pdf)

STM32H7

Buffer x16 | Buffer

SPI_1
Master

Filtering?

Ethernet

SPI (SCLK/MOSI/MISO)

nDRDY

DOUT0

DOUT1
DOUT7
SYNC_OUT
MCLK

SYNC_IN

ADC
AD7768 (https://www.analog.com/media/en/technical-documentation/data-sheets/ad7768-7768-4.pdf)

Mic 9

Mic 16

DOUT6

nDRDY

DOUT0

DOUT1
DOUT7
SYNC_OUT

MCLK

SYNC_IN (https://www.analog.com/media/en/technical-documentation/data-sheets/ad7768-7768-4.pdf)

SPI_2
Slave

DCLK

SPI

SPI

DCLK (https://www.analog.com/media/en/technical-documentation/data-sheets/ad7768-7768-4.pdf)

SPI_1 is the control and configuration channel
SPI_2 is a slave read-only channel for the ADC data.

When the ADC is operating in "One-shot" mode, the nDRDY line behaves differently to it's name: when data is ready to be ready out it goes high for the number of DCLK bits required to transfer the whole set of samples (from all the channels)
SPI_2 will be setup in dual-SPI mode to increase throughput while keeping the DCLK frequency low

The ADC's SYNC_IN signal must be synchronous to the MCLK. If this is not possible, there are 2 options to persue:

### 1. Send an asynchronous signal to nSTART, which will emit a synchronous signal

out of SYNC_OUT

### 2. Use a SPI command to start the conversion, which will also emit a synchronous

signal from SYNC_OUT

nSTART (https://www.analog.com/media/en/technical-documentation/data-sheets/ad7768-7768-4.pdf)

Fan out buffer:
LMK1C1102DQFR

32MHz oscillator
KC3225Z32.7680C1KX00

GPIO

SN74LVC125A

Active High (https://www.ti.com/product/SN74LVC125A)

Propagation delay
matching buffers

GPIO

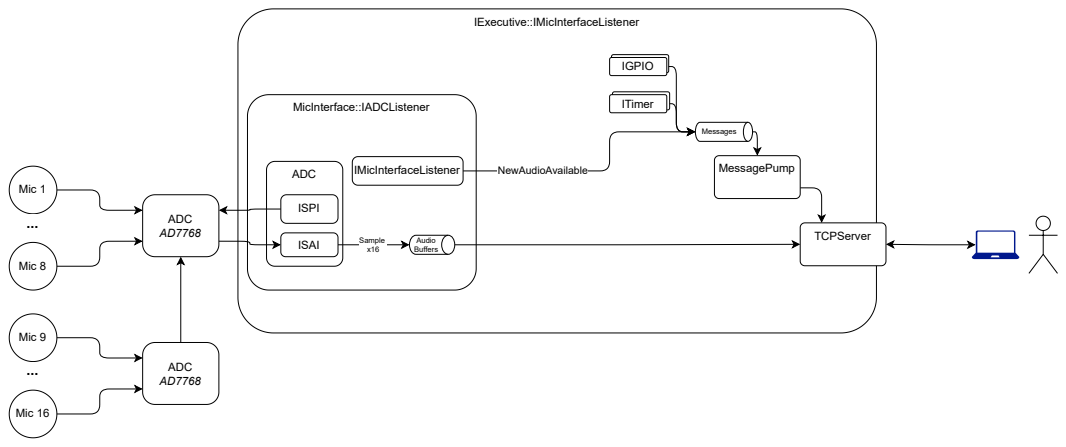
[picture p27: page 2]
IExecutive::IMicInterfaceListener; MicInterface::IADCListener; ADC; ADC AD7768; ISPI; ISAI; Audio; Buffers; Sample x16; TCPServer; Messages; NewAudioAvailable; MessagePump; ITimer; IGPIO; Mic 1; Mic 8; Mic 9; Mic 16; IMicInterfaceListener

3.3V

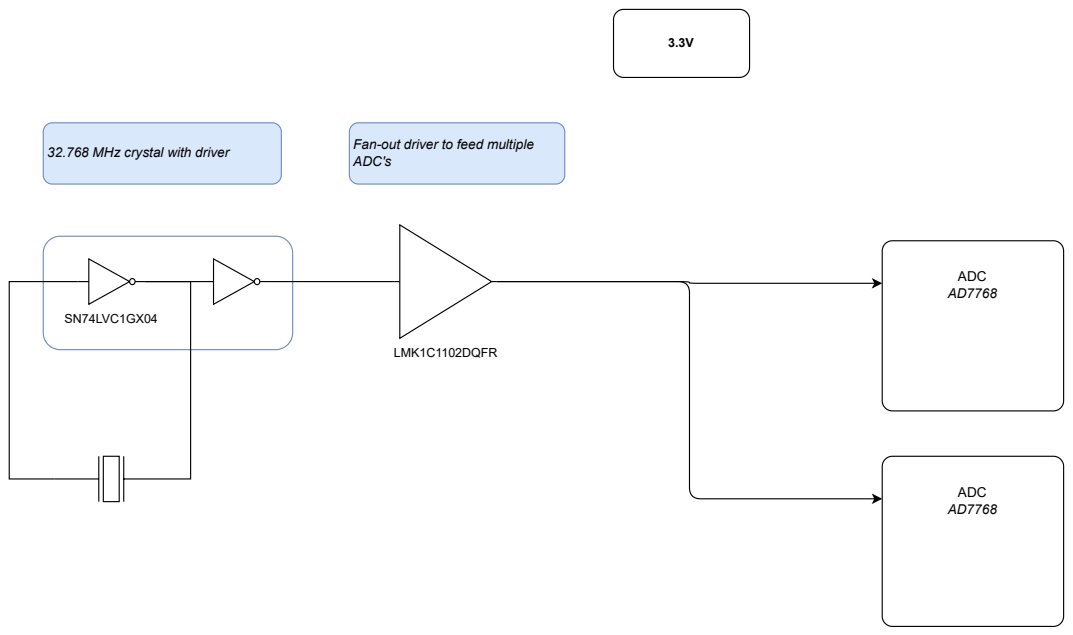
[picture p28: page 3]
ADC AD7768; SN74LVC1GX04; LMK1C1102DQFR

Fan-out driver to feed multiple
ADC's

32.768 MHz crystal with driver

# STM32H7

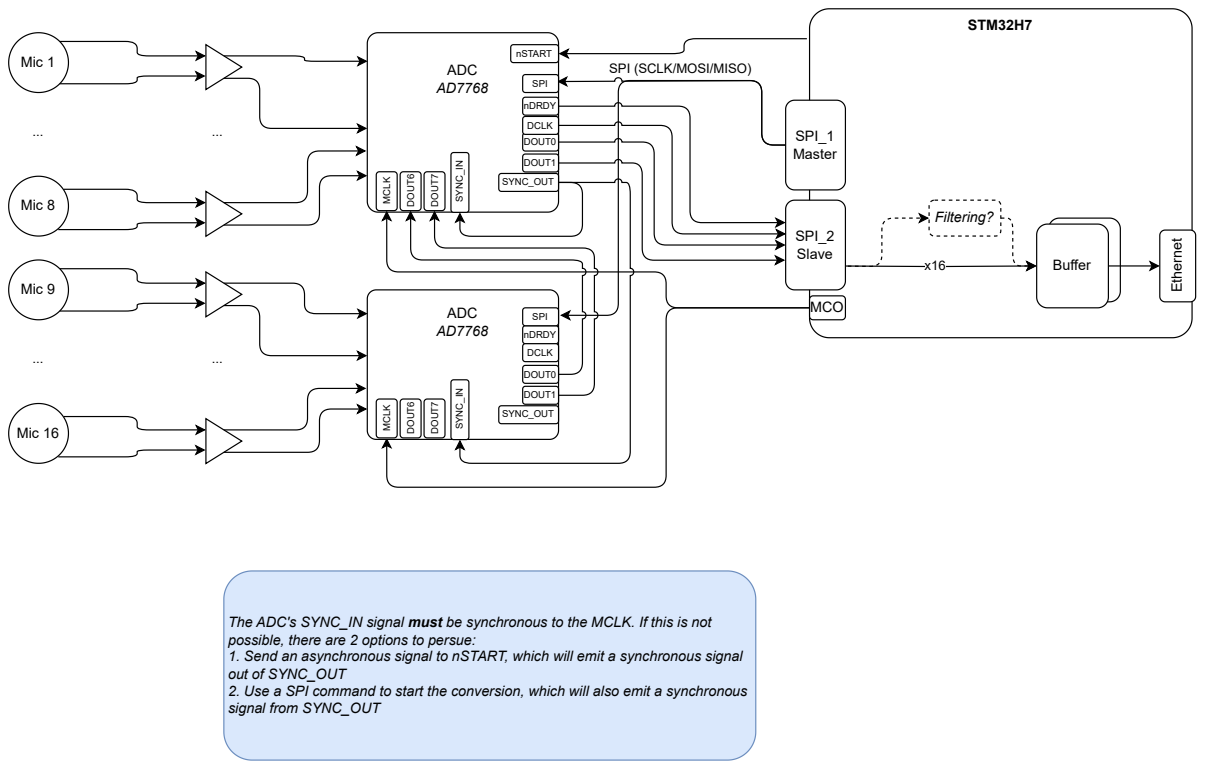
[picture p29: page 4]
ADC AD7768; Mic 1; Mic 8; DOUT6; Buffer; SPI_1 Master; Filtering?; Ethernet; MCO; nDRDY; DOUT0; DOUT1; DOUT7; SYNC_OUT; MCLK; SYNC_IN; Mic 9; Mic 16; SPI_2 Slave; DCLK; SPI; nSTART

SPI (SCLK/MOSI/MISO)

The ADC's SYNC_IN signal must be synchronous to the MCLK. If this is not
possible, there are 2 options to persue:
1. Send an asynchronous signal to nSTART, which will emit a synchronous signal
out of SYNC_OUT
2. Use a SPI command to start the conversion, which will also emit a synchronous
signal from SYNC_OUT

# Audio processing

# Serialisation

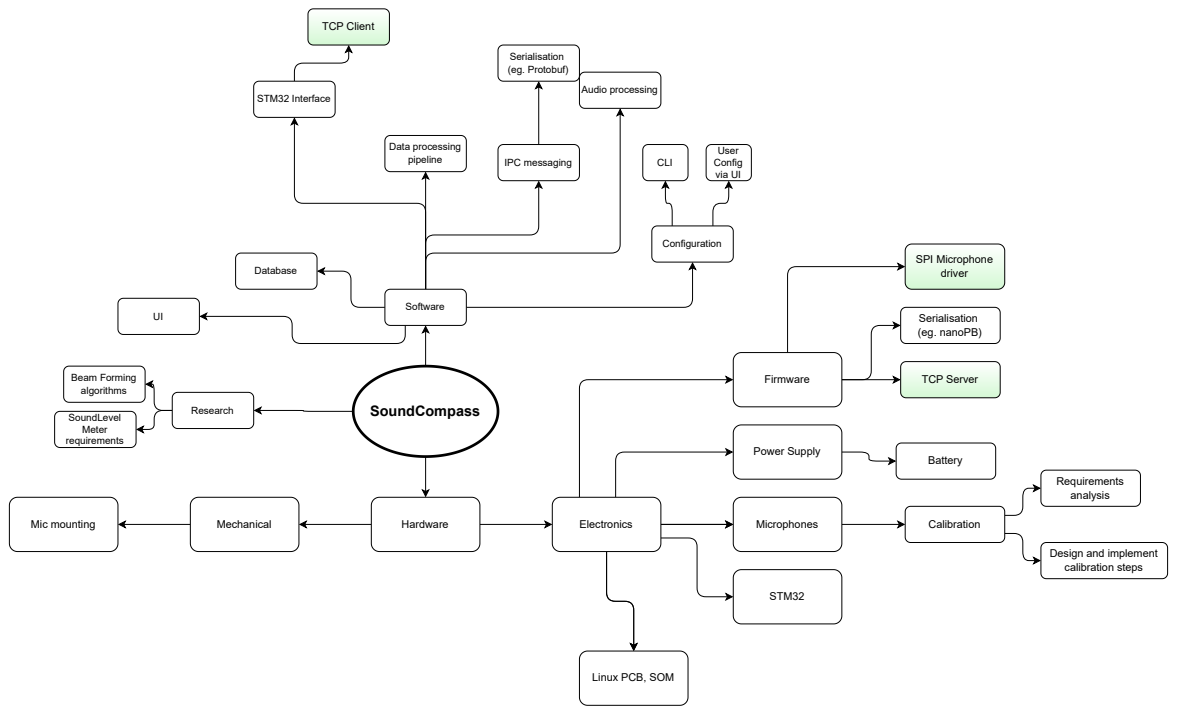
[picture p30: page 5]
SoundCompass; Software; Mechanical; Hardware; Electronics; Microphones; STM32; Mic mounting; Power Supply; Database; Data processing pipeline; Configuration; IPC messaging; CLI; User Config via UI; (eg. Protobuf); Firmware; SPI Microphone driver; STM32 Interface; TCP Client; TCP Server; Serialisation (eg. nanoPB); Calibration; Requirements analysis; Battery; Research; Beam Forming algorithms; SoundLevel Meter requirements

Design and implement
calibration steps

Linux PCB, SOM

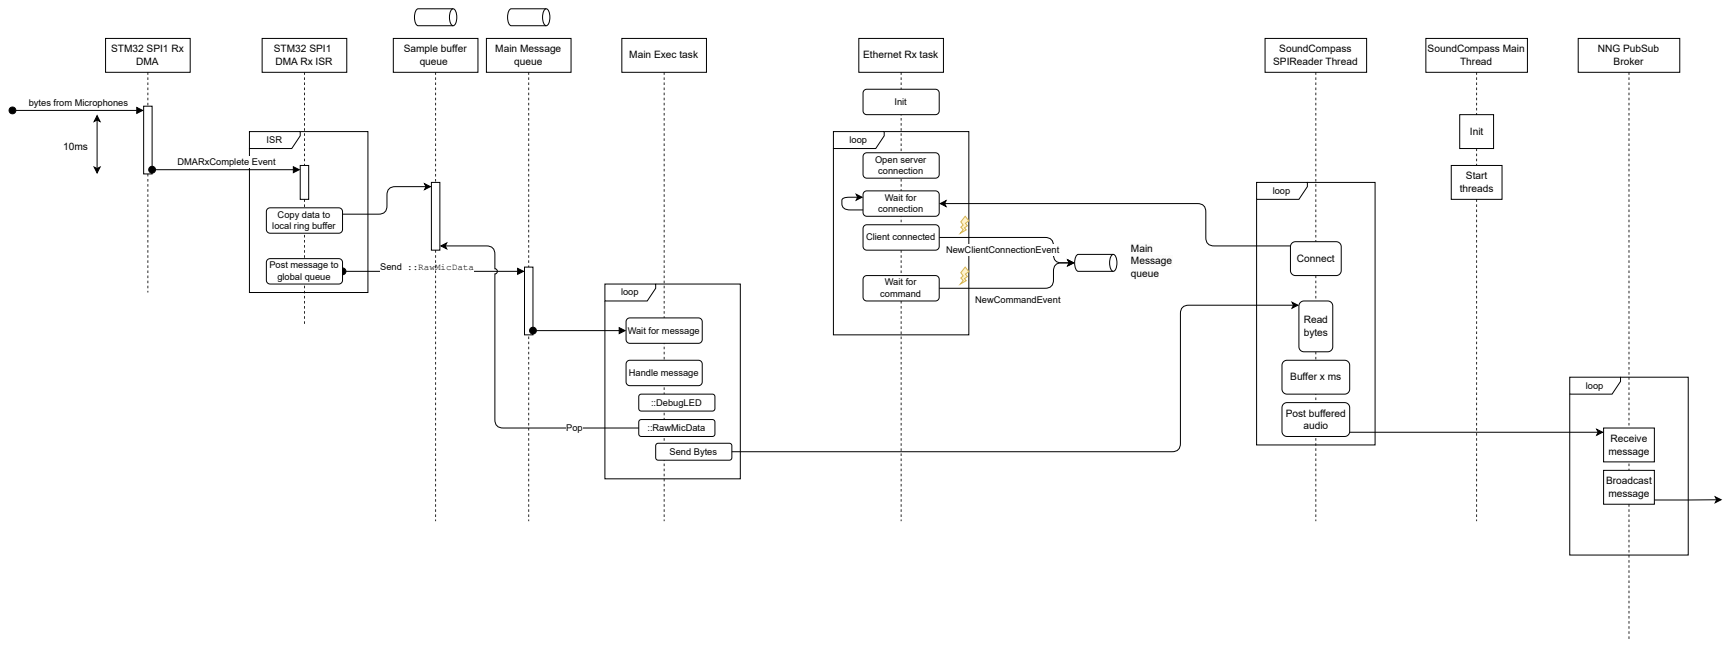
[picture p31: page 6]
loop; ISR; STM32 SPI1 Rx DMA; DMARxComplete Event; Send ::RawMicData; Main Message queue; SoundCompass SPIReader Thread; Read bytes; Buffer x ms; Connect; SoundCompass Main Thread; Init; Start threads; NNG PubSub Broker; Receive message; Post buffered audio; Broadcast message; Open server connection; Wait for connection; NewClientConnectionEvent; Client connected; NewCommandEvent; Wait for command; Handle message; ::DebugLED; Pop; ::RawMicData; Sample buffer queue; Send Bytes

STM32 SPI1
DMA Rx ISR

Main Exec task

Ethernet Rx task

bytes from Microphones

Copy data to
local ring buffer

Post message to
global queue

Wait for message

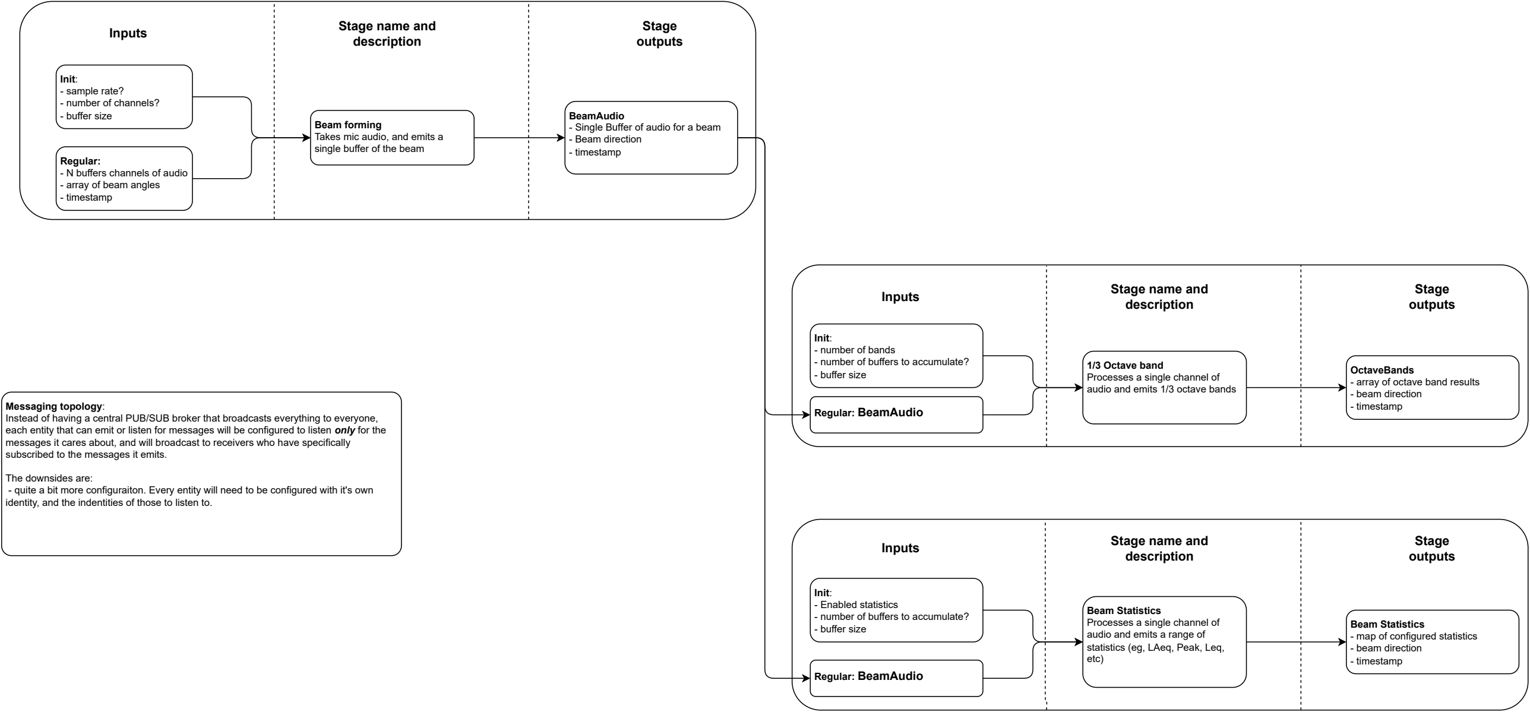
[picture p32: figure]
Messaging topology:; subscribed to the messages it emits.; The downsides are:; Inputs; Stage name and description; Stage outputs; Beam forming Takes mic audio, and emits a single buffer of the beam; BeamAudio - Single Buffer of audio for a beam - Beam direction - timestamp; Regular: - N buffers channels of audio - array of beam angles - timestamp; Init: - sample rate? - number of channels? - buffer size; Stage name and; description; 1/3 Octave band Processes a single channel of audio and emits 1/3 octave bands; OctaveBands - array of octave band results - beam direction - timestamp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

Instead of having a central PUB/SUB broker that broadcasts everything to everyone, each entity that can emit or listen for messages will be configured to listen only for the

# messages it cares about, and will broadcast to receivers who have specifically

# - quite a bit more configuraiton. Every entity will need to be configured with it's own

identity, and the indentities of those to listen to.

# Queue Broker

# Stage Manager

# Creates stages Reads stage config creates named queues if they don't already exist passes a Rx and Tx channel to for the queues to the stage

# Stage 1 Rx Chan

Tx

# Chan

Core | IProcessingEntity

# TxRxChannel

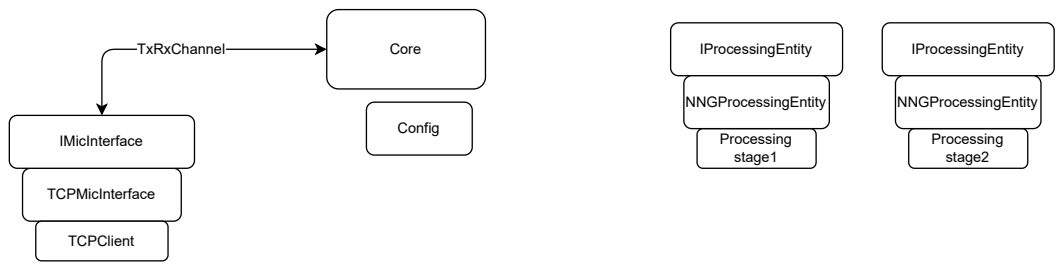
[picture p33: page 8]
TCPMicInterface; IMicInterface; TCPClient; Processing stage1; Config; NNGProcessingEntity; IProcessingEntity; Processing stage2

SPI Master: RP2040.

# RP2040 "pushes" samples to STM32. If STM32

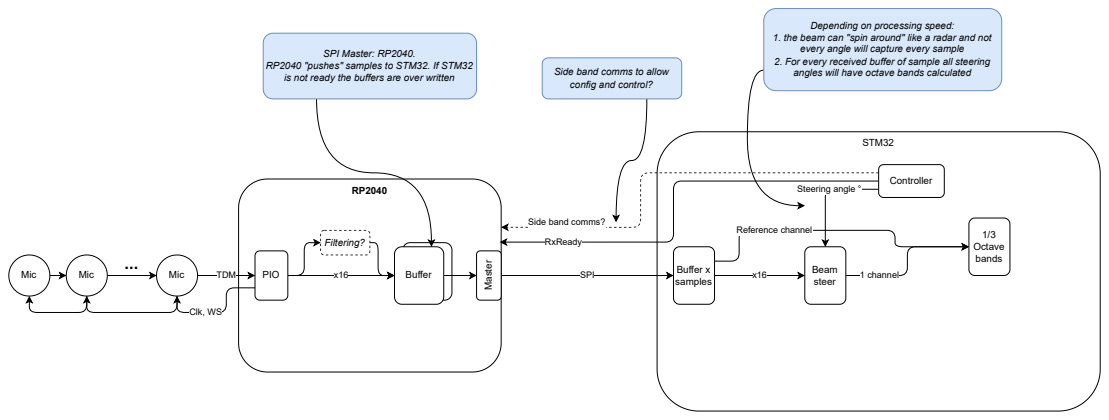
[picture p34: page 9]
STM32; Buffer; Mic; TDM; SPI; RxReady; Reference channel; Buffer x samples; Clk, WS; PIO; Filtering?; 1 channel; Steering angle °; Beam steer; 1/3 Octave bands; Controller; Side band comms to allow; angles will have octave bands calculated; Master

Depending on processing speed:

1. the beam can "spin around" like a radar and not
every angle will capture every sample
2. For every received buffer of sample all steering

config and control?

is not ready the buffers are over written

Side band comms?
