jbrryhooves/sound-compass/sim/ADC data output logic.asc

A1: or
A2: and
A3: srflop
A4: inv
A5: or
A6: inv
A7: inv
A10: or
V1: voltage; PULSE(0 1 .5 1n 1n .01 10)
V2: voltage; PULSE(1 0 1.5 1n 1n .01 10)
V3: voltage; 1
Named nets: 0, nReset, DATA_CLOCKING, DRDY, HI, SCLK, MISO1, MISO2
.tran 5
