jbrryhooves/sound-compass/sim/micpreamp.asc

B1: bv; V=V(Mic+)-V(Mic-)
B2: bv; V=-V(MicSignal)+0.66
B3: bv; V=V(MicSignal)+0.72
B5: bv; V=-V(MicSignal)+0.66
B6: bv; V=V(MicSignal)+0.72
C1: polcap; 22µ; V=6.3 Irms=632m Rser=0.2 Lser=0
C2: polcap; 22µ; V=6.3 Irms=632m Rser=0.2 Lser=0
C3: cap; 470p
C4: cap; 470pF
C5: cap; 22nF
C6: cap; 10nF
C7: cap; 10nF
C8: cap; 12pF
C9: polcap; 2.2µ; V=6.3 Irms=632m Rser=0.2 Lser=0
C10: cap; 300p
C11: cap; 300p
C12: cap; 10nf
C13: cap; 10nF
C14: cap; 10nF
C15: polcap; 2.2µ; V=6.3 Irms=632m Rser=0.2 Lser=0
C16: cap; .1µ
R1: res; 1.6k
R2: res; 550
R3: res; 550
R4: res; 1.6k
R5: res; 100k
R6: res; 430
R7: res; 33
R8: res; 33
R9: res; 1
R10: res; 1
R11: res; {1.6k*10}
R12: res; {550*10}
R13: res; {550*10}
R14: res; {1.6k*10}
R15: res; 100k
R16: res; 430
R17: res; 33
R18: res; 33
U1: ADA4940
U4: LTC1992
V3: voltage; 3.3
V4: voltage; {3.3/2}
V5: voltage; SINE(0 {1.2/2} 1000 0 0); AC AC 1.
Named nets: 0, Mic+, Mic-, Vcc, Vocm, MicSignal, OUT+, OUT-, Mic2+, Mic2-, OUT2+, OUT2-
.ac oct 24 1 100Meg
.tran 1000m
