jbrryhooves/sound-compass/sch/mic-test-board/mic-test-pcb.kicad_pcb

## KiCad design sch/mic-test-board/mic-test-pcb.kicad_pcb (2024-05-08)

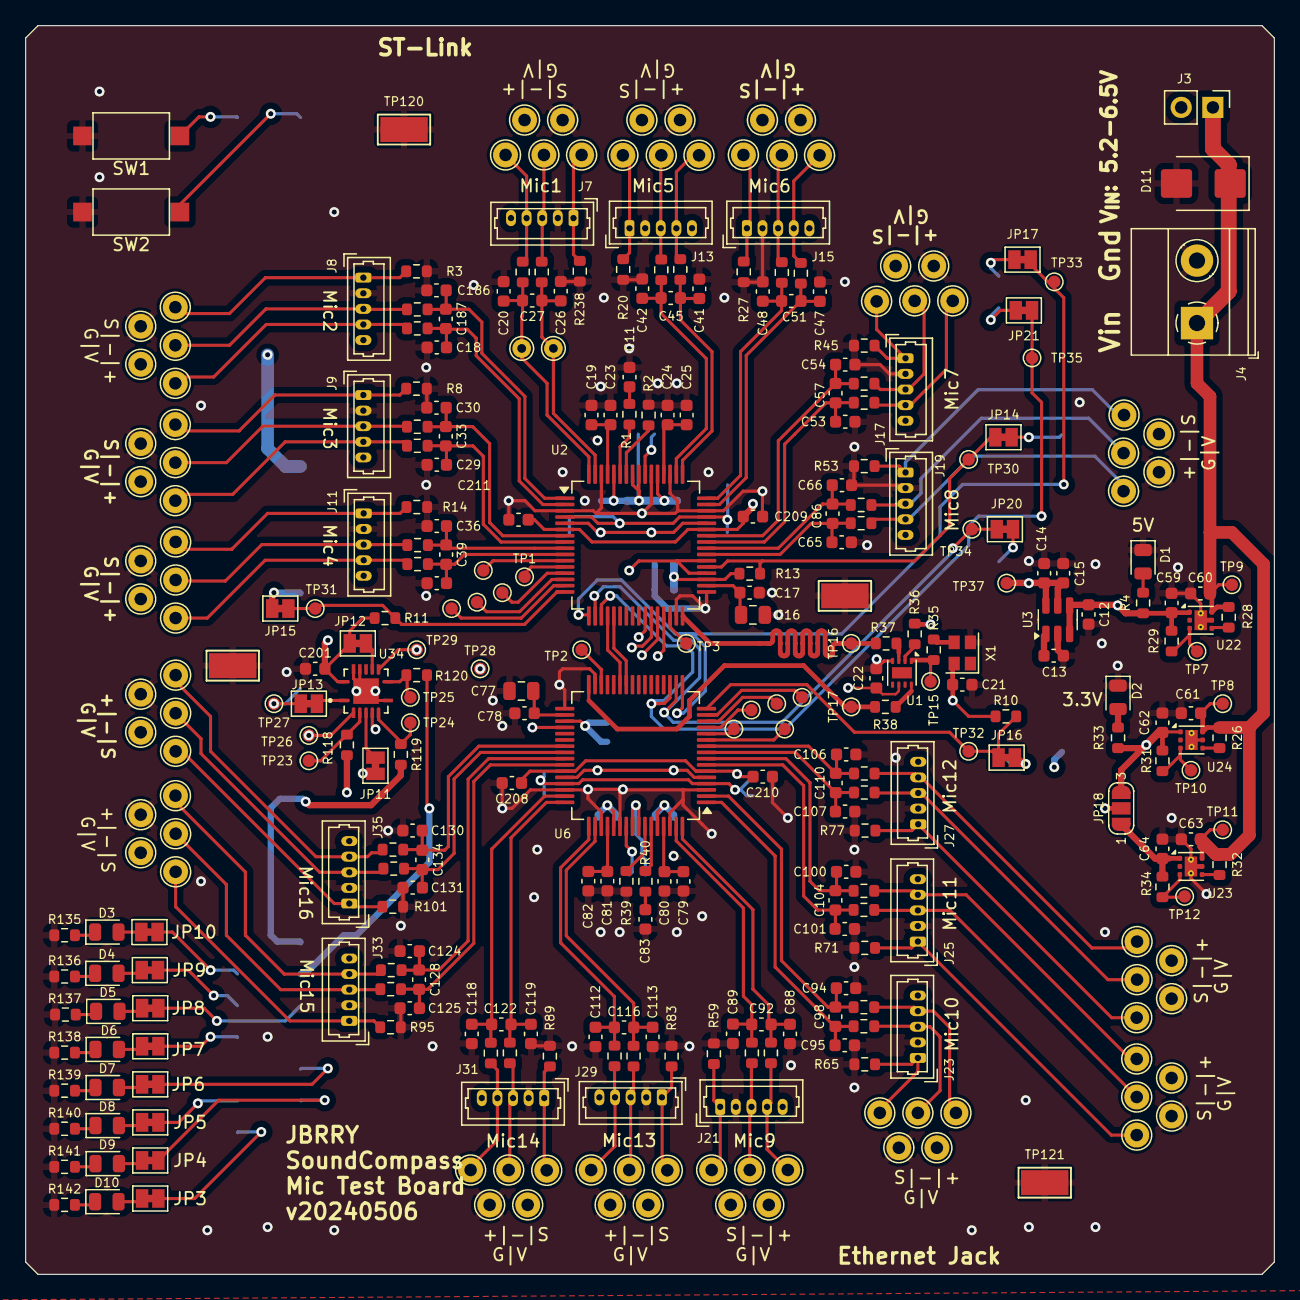
[picture p35: board mic-test-pcb.kicad_pcb from above]

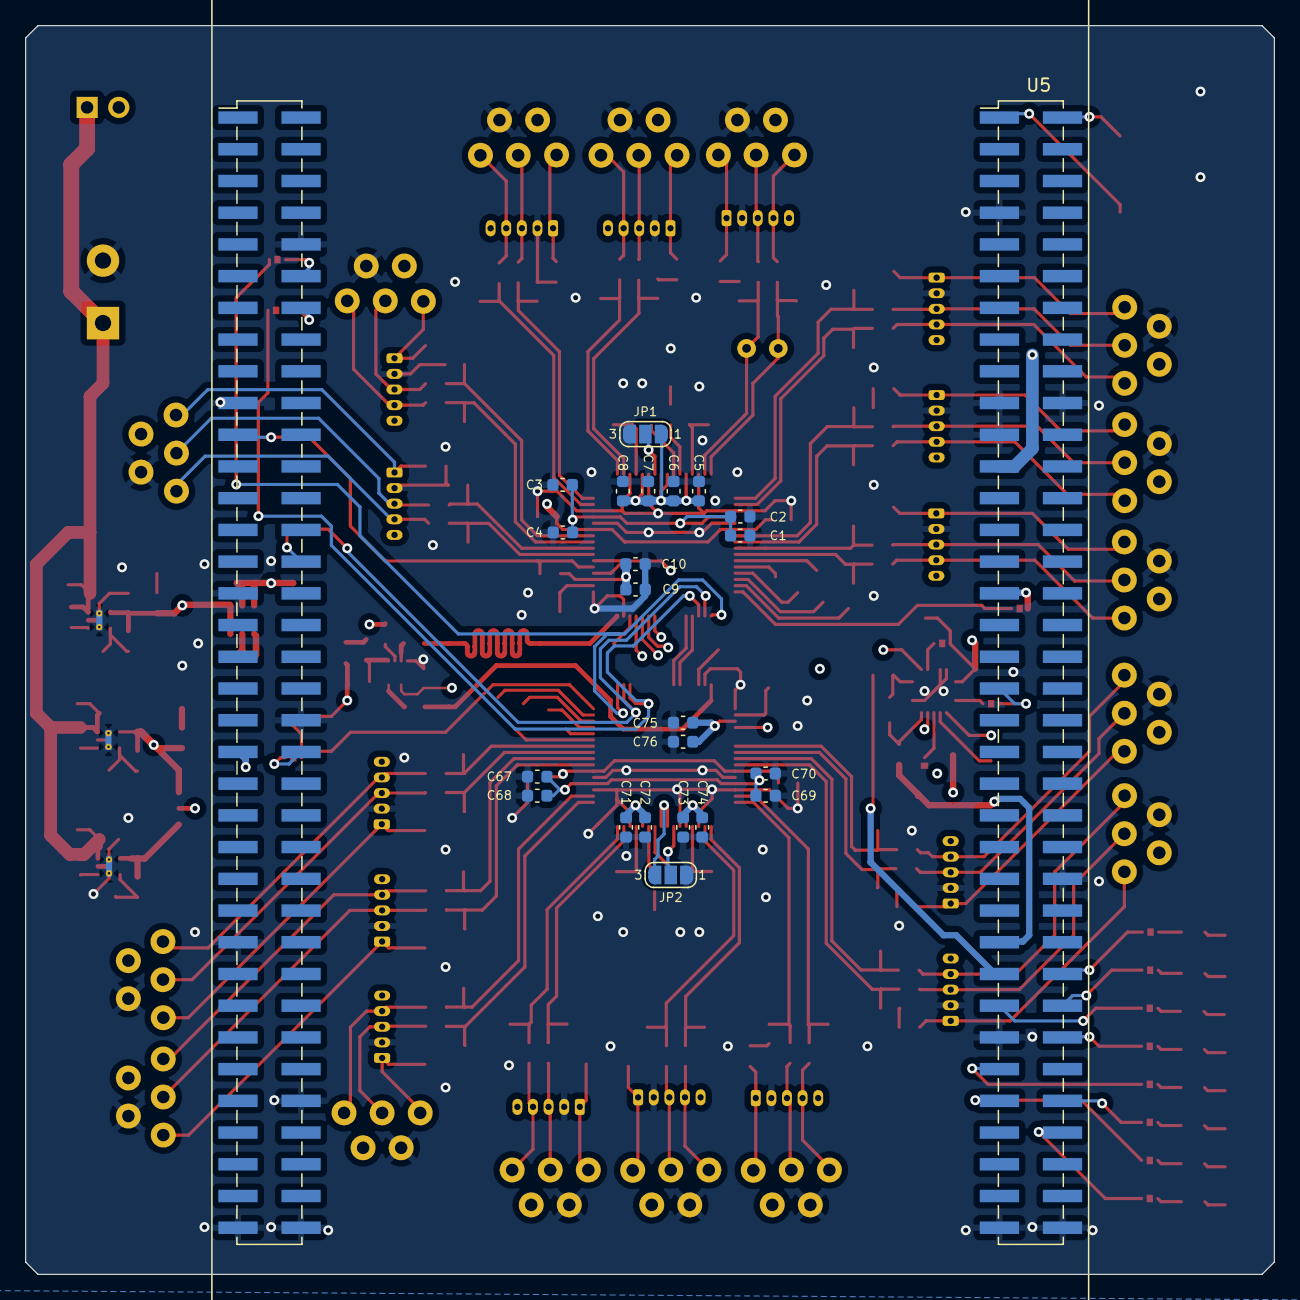
[picture p36: board mic-test-pcb.kicad_pcb from below]

Board: 4 copper layers, 100.0 x 100.0 mm, 359 parts (22 on the bottom side), 184 nets.

Parts:
C1, C3, C5, C7, C9, C12, C15, C19, C24, C59, C60, C61, C62, C63, C64, C67, C69, C71, C73, C75, C79, C81: 1uF; C_0603_1608Metric
C2, C4, C6, C8, C10, C11, C13, C14, C17, C21, C22, C23, C25, C68, C70, C72, C74, C76, C78, C80, C82, C83, C201, C208, C209, C210, C211: 0.1uF; C_0603_1608Metric
C16, C77: 10uF; C_0805_2012Metric
C18, C20, C26, C27, C29, C30, C33, C35, C36, C39, C41, C42, C45, C47, C48, C51, C53, C54, C57, C65, C66, C86, C88, C89, C92, C94, C95, C98, C100, C101, C104, C106, C107, C110, C112, C113, C116, C118, C119, C122, C124, C125, C128, C130, C131, C134, C186, C187: 10nF; C_0603_1608Metric
D1, D2, D3, D4, D5, D6, D7, D8, D9, D10: LED_Small_Filled; LED_0805_2012Metric
D11: SMBJ5340BE3/TR13; D_SMB
J3: Conn_01x03; PinHeader_1x02_P2.54mm_Vertical
J4: Conn_01x03; TerminalBlock_Phoenix_MKDS-1,5-2_1x02_P5.00mm_Horizontal
J7, J8, J9, J11, J13, J15, J17, J19, J21, J23, J25, J27, J29, J31, J33, J35: Conn_01x04; Molex_PicoBlade_53047-0510_1x05_P1.25mm_Vertical
JP1, JP2, JP18: SolderJumper_3_Open; SolderJumper-3_P1.3mm_Open_RoundedPad1.0x1.5mm_NumberLabels
JP3, JP4, JP5, JP6, JP7, JP8, JP9, JP10, JP11, JP12, JP13, JP14, JP15, JP16, JP17, JP20, JP21: SolderJumper_2_Bridged; SolderJumper-2_P1.3mm_Bridged_Pad1.0x1.5mm
R1, R40: 49.9R; R_0603_1608Metric
R2, R3, R8, R14, R20, R26, R27, R28, R32, R35, R37, R38, R39, R45, R53, R59, R65, R71, R77, R83, R89, R95, R101, R118, R119, R120, R238: 0R; R_0603_1608Metric
R4, R33, R135, R136, R137, R138, R139, R140, R141, R142: 470R; R_0603_1608Metric
R5, R6, R7, R9, R12, R15, R18, R21, R24, R30, R43, R46, R49, R54, R57, R60, R63, R66, R69, R72, R75, R78, R81, R84, R87, R90, R93, R96, R99, R102, R105, R223: 33R; R_0603_1608Metric
R10, R11, R13, R29, R31, R34, R36: 100k; R_0603_1608Metric
SW1, SW2: SW_Push; SW_SPST_CK_RS282G05A3
TP1, TP2, TP3, TP5, TP6, TP7, TP8, TP9, TP10, TP11, TP12, TP13, TP14, TP15, TP16, TP17, TP18, TP19, TP20, TP21, TP22, TP23, TP24, TP25, TP26, TP27, TP28, TP29, TP30, TP31, TP32, TP33, TP34, TP35, TP37: TestPoint; TestPoint_Pad_D1.0mm
TP4, TP36: Hole_1.5mm; TestPoint_THTPad_D1.5mm_Drill0.7mm
TP38, TP39, TP40, TP41, TP42, TP43, TP44, TP45, TP46, TP47, TP48, TP49, TP50, TP51, TP52, TP53, TP54, TP55, TP56, TP57, TP58, TP59, TP60, TP61, TP62, TP63, TP64, TP65, TP66, TP67, TP68, TP69, TP70, TP71, TP72, TP73, TP74, TP75, TP76, TP77, TP78, TP79, TP80, TP81, TP82, TP83, TP84, TP85, TP86, TP87, TP88, TP89, TP90, TP91, TP92, TP93, TP94, TP95, TP96, TP97, TP98, TP99, TP100, TP101, TP102, TP103, TP104, TP105, TP106, TP107, TP108, TP109, TP110, TP111, TP112, TP113, TP114, TP115, TP116, TP117: Hole_1.5mm; TestPoint_THTPad_D2.0mm_Drill1.0mm
TP118: 5019; TestPoint_Keystone_5019_Minature
TP119, TP120, TP121: Hole_1.5mm; TestPoint_Keystone_5019_Minature
U1: LMK1C1102; WSON-8-1EP_2x2mm_P0.5mm_EP0.9x1.6mm
U2, U6: AD7768BSTZ; LQFP-64_10x10mm_P0.5mm
U3: MAX6070BAUT33+T; SOT-23-6
U5: NUCLEO144-H743ZI; ST_Morpho_Connector_144_STLink_SMD_Headers_BottomMount
U22: LP5912-5.0DRV; WSON-6-1EP_2x2mm_P0.65mm_EP1x1.6mm_ThermalVias
U23, U24: LP5912-3.3DRV; WSON-6-1EP_2x2mm_P0.65mm_EP1x1.6mm_ThermalVias
U34: SN74LVC126ARGYR; IC_SN74AUC08RGYRG4
X1: KC3225Z32.7680C1KX00; Oscillator_SMD_SeikoEpson_SG210-4Pin_2.5x2.0mm

Connections:
+3.3V: C5.1, C6.1, C7.1, C8.1, C9.1, C10.1, C21.1, C22.1, C62.1, C71.1, C72.1, C73.1, C74.1, C75.1, C76.1, C201.1, JP1.3 (B), JP2.3 (B), JP11.1 (A), JP12.1 (A), JP18.3 (B), R10.2, R11.2, R13.2, R31.2, R33.1, R36.2, U1.6 (VCC), U2.35 (IOVDD), U2.53 (AVDD2B), U2.56 (FORMAT0), U2.57 (~PIN/SPI), U2.60 (AVDD2A), U6.35 (IOVDD), U6.53 (AVDD2B), U6.56 (FORMAT0), U6.57 (~PIN/SPI), U6.60 (AVDD2A), U24.1 (OUT), U34.14 (VCC), X1.4 (Vcc)
+3.3VA: J7.5, J8.5, J9.5, J11.5, J13.5, J15.5, J17.5, J19.5, J21.5, J23.5, J25.5, J27.5, J29.5, J31.5, J33.5, J35.5, JP18.2 (C), TP38.1, TP40.1, TP42.1, TP44.1, TP46.1, TP48.1, TP50.1, TP52.1, TP54.1, TP56.1, TP58.1, TP60.1, TP62.1, TP64.1, TP66.1, TP68.1
+5VA: C1.1, C2.1, C3.1, C4.1, C12.1, C59.1, C67.1, C68.1, C69.1, C70.1, R4.1, R29.2, U2.4 (AVDD1A), U2.45 (AVDD1B), U3.3 (EN), U3.4 (IN), U6.4 (AVDD1A), U6.45 (AVDD1B), U22.1 (OUT)
/ADC1 AD7768/AIN0+: C20.2, C27.1, R7.2, TP4.1, U2.64 (AIN0+)
/ADC1 AD7768/AIN0-: C26.1, C27.2, R223.2, TP36.1, U2.63 (AIN0-)
/ADC1 AD7768/AIN1+: C18.2, C187.1, R5.2, U2.2 (AIN1+)
/ADC1 AD7768/AIN1-: C186.1, C187.2, R6.2, U2.1 (AIN1-)
/ADC1 AD7768/AIN2+: C29.2, C33.1, R9.2, U2.8 (AIN2+)
/ADC1 AD7768/AIN2-: C30.1, C33.2, R12.2, U2.7 (AIN2-)
/ADC1 AD7768/AIN3+: C35.2, C39.1, R15.2, U2.10 (AIN3+)
/ADC1 AD7768/AIN3-: C36.1, C39.2, R18.2, U2.9 (AIN3-)
/ADC1 AD7768/AIN4+: C41.2, C45.1, R21.2, U2.49 (AIN4+)
/ADC1 AD7768/AIN4-: C42.1, C45.2, R24.2, U2.50 (AIN4-)
/ADC1 AD7768/AIN5+: C47.2, C51.1, R30.2, U2.47 (AIN5+)
/ADC1 AD7768/AIN5-: C48.1, C51.2, R43.2, U2.48 (AIN5-)
/ADC1 AD7768/AIN6+: C53.2, C57.1, R46.2, U2.41 (AIN6+)
/ADC1 AD7768/AIN6-: C54.1, C57.2, R49.2, U2.42 (AIN6-)
/ADC1 AD7768/AIN7+: C65.2, C86.1, R54.2, U2.39 (AIN7+)
/ADC1 AD7768/AIN7-: C66.1, C86.2, R57.2, U2.40 (AIN7-)
/ADC1 AD7768/DCLK: TP26.1, U2.28 (DCLK), U34.2 (A1)
/ADC1 AD7768/DOUT0: TP28.1, U2.27 (DOUT0), U34.5 (A2)
/ADC1 AD7768/DOUT1: TP29.1, U2.26 (DOUT1), U34.9 (A3)
/ADC1 AD7768/DOUT6: U2.21 (DOUT6), U6.26 (DOUT1)
/ADC1 AD7768/DOUT7: U2.20 (DOUT7), U6.27 (DOUT0)
/ADC1 AD7768/DREGCAP: C16.1, C17.1, U2.34 (DREGCAP)
/ADC1 AD7768/REGCAPA: C19.1, C23.1, U2.61 (REGCAPA)
/ADC1 AD7768/REGCAPB: C24.1, C25.1, U2.52 (REGCAPB)
/ADC1 AD7768/V_{OCM}: C11.1, R1.2
/ADC1 AD7768/~START: JP14.1 (A), R13.1, TP30.1, U2.37 (~START)
/ADC1 AD7768/~SYNC_IN: U2.36 (~SYNC_IN), U2.38 (~SYNC_OUT), U6.36 (~SYNC_IN)
/ADC2 AD7769/AIN0+: C88.2, C92.1, R60.2, U6.64 (AIN0+)
/ADC2 AD7769/AIN0-: C89.1, C92.2, R63.2, U6.63 (AIN0-)
/ADC2 AD7769/AIN1+: C94.2, C98.1, R66.2, U6.2 (AIN1+)
/ADC2 AD7769/AIN1-: C95.1, C98.2, R69.2, U6.1 (AIN1-)
/ADC2 AD7769/AIN2+: C100.2, C104.1, R72.2, U6.8 (AIN2+)
/ADC2 AD7769/AIN2-: C101.1, C104.2, R75.2, U6.7 (AIN2-)
/ADC2 AD7769/AIN3+: C106.2, C110.1, R78.2, U6.10 (AIN3+)
/ADC2 AD7769/AIN3-: C107.1, C110.2, R81.2, U6.9 (AIN3-)
/ADC2 AD7769/AIN4+: C112.2, C116.1, R84.2, U6.49 (AIN4+)
/ADC2 AD7769/AIN4-: C113.1, C116.2, R87.2, U6.50 (AIN4-)
/ADC2 AD7769/AIN5+: C118.2, C122.1, R90.2, U6.47 (AIN5+)
/ADC2 AD7769/AIN5-: C119.1, C122.2, R93.2, U6.48 (AIN5-)
/ADC2 AD7769/AIN6+: C124.2, C128.1, R96.2, U6.41 (AIN6+)
/ADC2 AD7769/AIN6-: C125.1, C128.2, R99.2, U6.42 (AIN6-)
/ADC2 AD7769/AIN7+: C130.2, C134.1, R102.2, U6.39 (AIN7+)
/ADC2 AD7769/AIN7-: C131.1, C134.2, R105.2, U6.40 (AIN7-)
/ADC2 AD7769/DREGCAP: C77.1, C78.1, U6.34 (DREGCAP)
/ADC2 AD7769/REGCAPA: C79.1, C80.1, U6.61 (REGCAPA)
/ADC2 AD7769/REGCAPB: C81.1, C82.1, U6.52 (REGCAPB)
/ADC2 AD7769/V_{OCM}: C83.1, R40.2
/DRDY: JP13.1 (A), TP27.1, U2.29 (~DRDY), U5.38 (PC0)
/MCLK_1: R37.2, TP16.1, U2.32 (XTAL2/MCLK)
/MCLK_2: R38.2, TP17.1, U6.32 (XTAL2/MCLK)
/SPI1_MISO: JP21.1 (A), TP35.1, U2.19 (DEC0/SDO), U6.19 (DEC0/SDO)
/SPI1_MOSI: JP20.1 (A), TP34.1, U2.18 (DEC1/SDI), U6.18 (DEC1/SDI)
/SPI1_SCLK: JP17.1 (A), TP33.1, U2.17 (ST1/SCLK), U6.17 (ST1/SCLK)
/SPI1_~CS1: JP15.1 (A), R11.1, TP31.1, U2.16 (ST0/~CS)
/SPI1_~CS2: JP16.1 (A), R10.1, TP32.1, U6.16 (ST0/~CS)
/V_{IN}: C60.1, C61.1, C63.1, D11.1 (K), J3.1, J4.1, R26.1, R28.1, R32.1, TP8.1, TP9.1, TP11.1, U22.6 (IN), U23.6 (IN), U24.6 (IN)
/V_{REF}: C14.1, C15.1, C208.1, C209.1, C210.1, C211.1, TP37.1, U2.6 (REF1+), U2.43 (REF2+), U3.5 (OUTS), U3.6 (OUTF), U6.6 (REF1+), U6.43 (REF2+)
/uController/GPIO_~START_uC: JP14.2 (B), U5.94 (PB2)
/uController/LED1: D10.2 (A), JP3.2 (B)
/uController/LED1_uC: JP3.1 (A), U5.65 (PG12)
/uController/LED2: D9.2 (A), JP4.2 (B)
/uController/LED2_uC: JP4.1 (A), U5.64 (PG15)
/uController/LED3: D8.2 (A), JP5.2 (B)
/uController/LED3_uC: JP5.1 (A), U5.63 (PG9)
/uController/LED4: D7.2 (A), JP6.2 (B)
/uController/LED4_uC: JP6.1 (A), U5.62 (PE6)
/uController/LED5: D6.2 (A), JP7.2 (B)
/uController/LED5_uC: JP7.1 (A), U5.59 (PG0)
/uController/LED6: D5.2 (A), JP8.2 (B)
/uController/LED6_uC: JP8.1 (A), U5.58 (PG1)
/uController/LED7: D4.2 (A), JP9.2 (B)
/uController/LED7_uC: JP9.1 (A), U5.57 (PD0)
/uController/LED8: D3.2 (A), JP10.2 (B)
/uController/LED8_uC: JP10.1 (A), U5.55 (PD1)
/uController/SPI1_MISO_uC: JP21.2 (B), U5.85 (PA6)
/uController/SPI1_MOSI_uC: JP20.2 (B), U5.101 (PB5)
/uController/SPI1_SCLK_uC: JP17.2 (B), U5.83 (PA5)
/uController/SPI1_~CS1_uC: JP15.2 (B), U5.32 (PA4)
/uController/SPI1_~CS2_uC: JP16.2 (B), U5.113 (PD13)
/uController/SPI2_MOSI1_buff: R119.2, U5.54 (PF8)
/uController/SPI2_MOSI2_buff: R120.2, U5.56 (PF9)
/uController/SPI2_SCLK_buff: R118.2, U5.114 (PF10)
/uController/V_{IN}: J3.2, U5.24 (VIN)
/uController/~PButton1: SW1.1, U5.1 (PC10)
/uController/~PButton2: SW2.1, U5.2 (PC11)
GND: C1.2, C2.2, C3.2, C4.2, C5.2, C6.2, C7.2, C8.2, C9.2, C10.2, C11.2, C12.2, C13.2, C14.2, C15.2, C16.2, C17.2, C18.1, C19.2, C20.1, C21.2, C22.2, C23.2, C24.2, C25.2, C26.2, C29.1, C30.2, C35.1, C36.2, C41.1, C42.2, C47.1, C48.2, C53.1, C54.2, C59.2, C60.2, C61.2, C62.2, C63.2, C64.2, C65.1, C66.2, C67.2, C68.2, C69.2, C70.2, C71.2, C72.2, C73.2, C74.2, C75.2, C76.2, C77.2, C78.2, C79.2, C80.2, C81.2, C82.2, C83.2, C88.1, C89.2, C94.1, C95.2, C100.1, C101.2, C106.1, C107.2, C112.1, C113.2, C118.1, C119.2, C124.1, C125.2, C130.1, C131.2, C186.2, C201.2, C208.2, C209.2, C210.2, C211.2, D1.1 (K), D2.1 (K), D11.2 (A), J4.2, J7.2, J8.2, J9.2, J11.2, J13.2, J15.2, J17.2, J19.2, J21.2, J23.2, J25.2, J27.2, J29.2, J31.2, J33.2, J35.2, JP1.1 (A), JP2.1 (A), R2.1, R3.1, R8.1, R14.1, R20.1, R27.1, R39.1, R45.1, R53.1, R59.1, R65.1, R71.1, R77.1, R83.1, R89.1, R95.1, R101.1, R135.2, R136.2, R137.2, R138.2, R139.2, R140.2, R141.2, R142.2, R238.1, SW1.2, SW2.2, TP86.1, TP87.1, TP88.1, TP89.1, TP90.1, TP91.1, TP92.1, TP93.1, TP94.1, TP95.1, TP96.1, TP97.1, TP98.1, TP99.1, TP100.1, TP101.1, TP118.1, TP119.1, TP120.1, TP121.1, U1.4 (GND), U2.3 (AVSS1A), U2.5 (REF1-), U2.31 (XTAL1), U2.33 (DGND), U2.44 (REF2-), U2.46 (AVSS1B), U2.51 (AVSS2B), U2.54 (AVSS), U2.62 (AVSS2A), U3.2 (GND), U5.8 (GND), U5.19 (GND), U5.20 (GND), U5.22 (GND), U5.49 (GND), U5.60 (GND), U5.71 (GND), U5.72 (GND), U5.81 (GND), U5.92 (GND), U5.104 (AGND), U5.111 (GND), U5.126 (GND), U5.135 (GND), U5.143 (GND), U5.144 (GND), U6.3 (AVSS1A), U6.5 (REF1-), U6.31 (XTAL1), U6.33 (DGND), U6.44 (REF2-), U6.46 (AVSS1B), U6.51 (AVSS2B), U6.54 (AVSS), U6.62 (AVSS2A), U22.5 (GND), U22.7 (EP), U23.5 (GND), U23.7 (EP), U24.5 (GND), U24.7 (EP), U34.7 (GND), U34.12 (A4), U34.13, U34.15 (EP), X1.2 (GND)
unnamed: D1.2 (A), R4.2
unnamed: D2.2 (A), R33.2
unnamed: D3.1 (K), R135.1
unnamed: D4.1 (K), R136.1
unnamed: D5.1 (K), R137.1
unnamed: D6.1 (K), R138.1
unnamed: D7.1 (K), R139.1
unnamed: D8.1 (K), R140.1
unnamed: D9.1 (K), R141.1
unnamed: D10.1 (K), R142.1
unnamed: J7.1, R238.2, TP103.1
unnamed: J7.3, R223.1, TP71.1
unnamed: J7.4, R7.1, TP41.1
unnamed: J8.1, R3.2, TP106.1
unnamed: J8.3, R6.1, TP74.1
unnamed: J8.4, R5.1, TP47.1
unnamed: J9.1, R8.2, TP102.1
unnamed: J9.3, R12.1, TP70.1
unnamed: J9.4, R9.1, TP39.1
unnamed: J11.1, R14.2, TP104.1
unnamed: J11.3, R18.1, TP72.1
unnamed: J11.4, R15.1, TP43.1
unnamed: J13.1, R20.2, TP105.1
unnamed: J13.3, R24.1, TP73.1
unnamed: J13.4, R21.1, TP45.1
unnamed: J15.1, R27.2, TP107.1
unnamed: J15.3, R43.1, TP75.1
unnamed: J15.4, R30.1, TP49.1
unnamed: J17.1, R45.2, TP108.1
unnamed: J17.3, R49.1, TP76.1
unnamed: J17.4, R46.1, TP51.1
unnamed: J19.1, R53.2, TP109.1
unnamed: J19.3, R57.1, TP77.1
unnamed: J19.4, R54.1, TP53.1
unnamed: J21.1, R59.2, TP110.1
unnamed: J21.3, R63.1, TP78.1
unnamed: J21.4, R60.1, TP55.1
unnamed: J23.1, R65.2, TP111.1
unnamed: J23.3, R69.1, TP79.1
unnamed: J23.4, R66.1, TP57.1
unnamed: J25.1, R71.2, TP112.1
unnamed: J25.3, R75.1, TP80.1
unnamed: J25.4, R72.1, TP59.1
unnamed: J27.1, R77.2, TP113.1
unnamed: J27.3, R81.1, TP81.1
unnamed: J27.4, R78.1, TP61.1
unnamed: J29.1, R83.2, TP114.1
unnamed: J29.3, R87.1, TP82.1
unnamed: J29.4, R84.1, TP63.1
unnamed: J31.1, R89.2, TP115.1
unnamed: J31.3, R93.1, TP83.1
unnamed: J31.4, R90.1, TP65.1
unnamed: J33.1, R95.2, TP116.1
unnamed: J33.3, R99.1, TP84.1
unnamed: J33.4, R96.1, TP67.1
unnamed: J35.1, R101.2, TP117.1
unnamed: J35.3, R105.1, TP85.1
unnamed: J35.4, R102.1, TP69.1
unnamed: JP1.2 (C), U2.55 (FORMAT1)
unnamed: JP2.2 (C), U6.55 (FORMAT1)
unnamed: JP11.2 (B), U34.4
unnamed: JP12.2 (B), U34.10
unnamed: JP13.2 (B), U34.1
unnamed: C64.1, JP18.1 (A), R34.2, U23.1 (OUT)
unnamed: R118.1, TP23.1, U34.3
unnamed: R119.1, TP24.1, U34.6
unnamed: R120.1, TP25.1, U34.8
unnamed: R36.1, U1.2 (1G/Enable)
unnamed: R35.2, TP15.1, U1.1 (CLKIN)
unnamed: R37.1, U1.3 (Y0)
unnamed: R38.1, U1.8 (Y1)
unnamed: R2.2, U2.58 (CLK_SEL)
unnamed: TP14.1, U2.11 (FILTER/GPIO4)
unnamed: TP1.1, U2.12 (MODE0/GPIO0)
unnamed: TP5.1, U2.13 (MODE1/GPIO1)
unnamed: TP6.1, U2.14 (MODE2/GPIO2)
unnamed: TP13.1, U2.15 (MODE3/GPIO3)
unnamed: R1.1, U2.59 (VCM)
unnamed: TP3.1, U2.30 (~RESET)
unnamed: C13.1, U3.1 (FILTER)
unnamed: R39.2, U6.58 (CLK_SEL)
unnamed: TP22.1, U6.11 (FILTER/GPIO4)
unnamed: TP18.1, U6.12 (MODE0/GPIO0)
unnamed: TP19.1, U6.13 (MODE1/GPIO1)
unnamed: TP20.1, U6.14 (MODE2/GPIO2)
unnamed: TP21.1, U6.15 (MODE3/GPIO3)
unnamed: R40.1, U6.59 (VCM)
unnamed: TP2.1, U6.30 (~RESET)
unnamed: R28.2, U22.4 (EN)
unnamed: R29.1, TP7.1, U22.3 (PG)
unnamed: R32.2, U23.4 (EN)
unnamed: R34.1, TP12.1, U23.3 (PG)
unnamed: R26.2, U24.4 (EN)
unnamed: R31.1, TP10.1, U24.3 (PG)
unnamed: R35.1, X1.3 (OUT)
