jbrryhooves/sound-compass/sch/mic-test-board_micboard/mic-test-board_micboard.kicad_pcb

## KiCad design sch/mic-test-board_micboard/mic-test-board_micboard.kicad_pcb (2024-05-08)

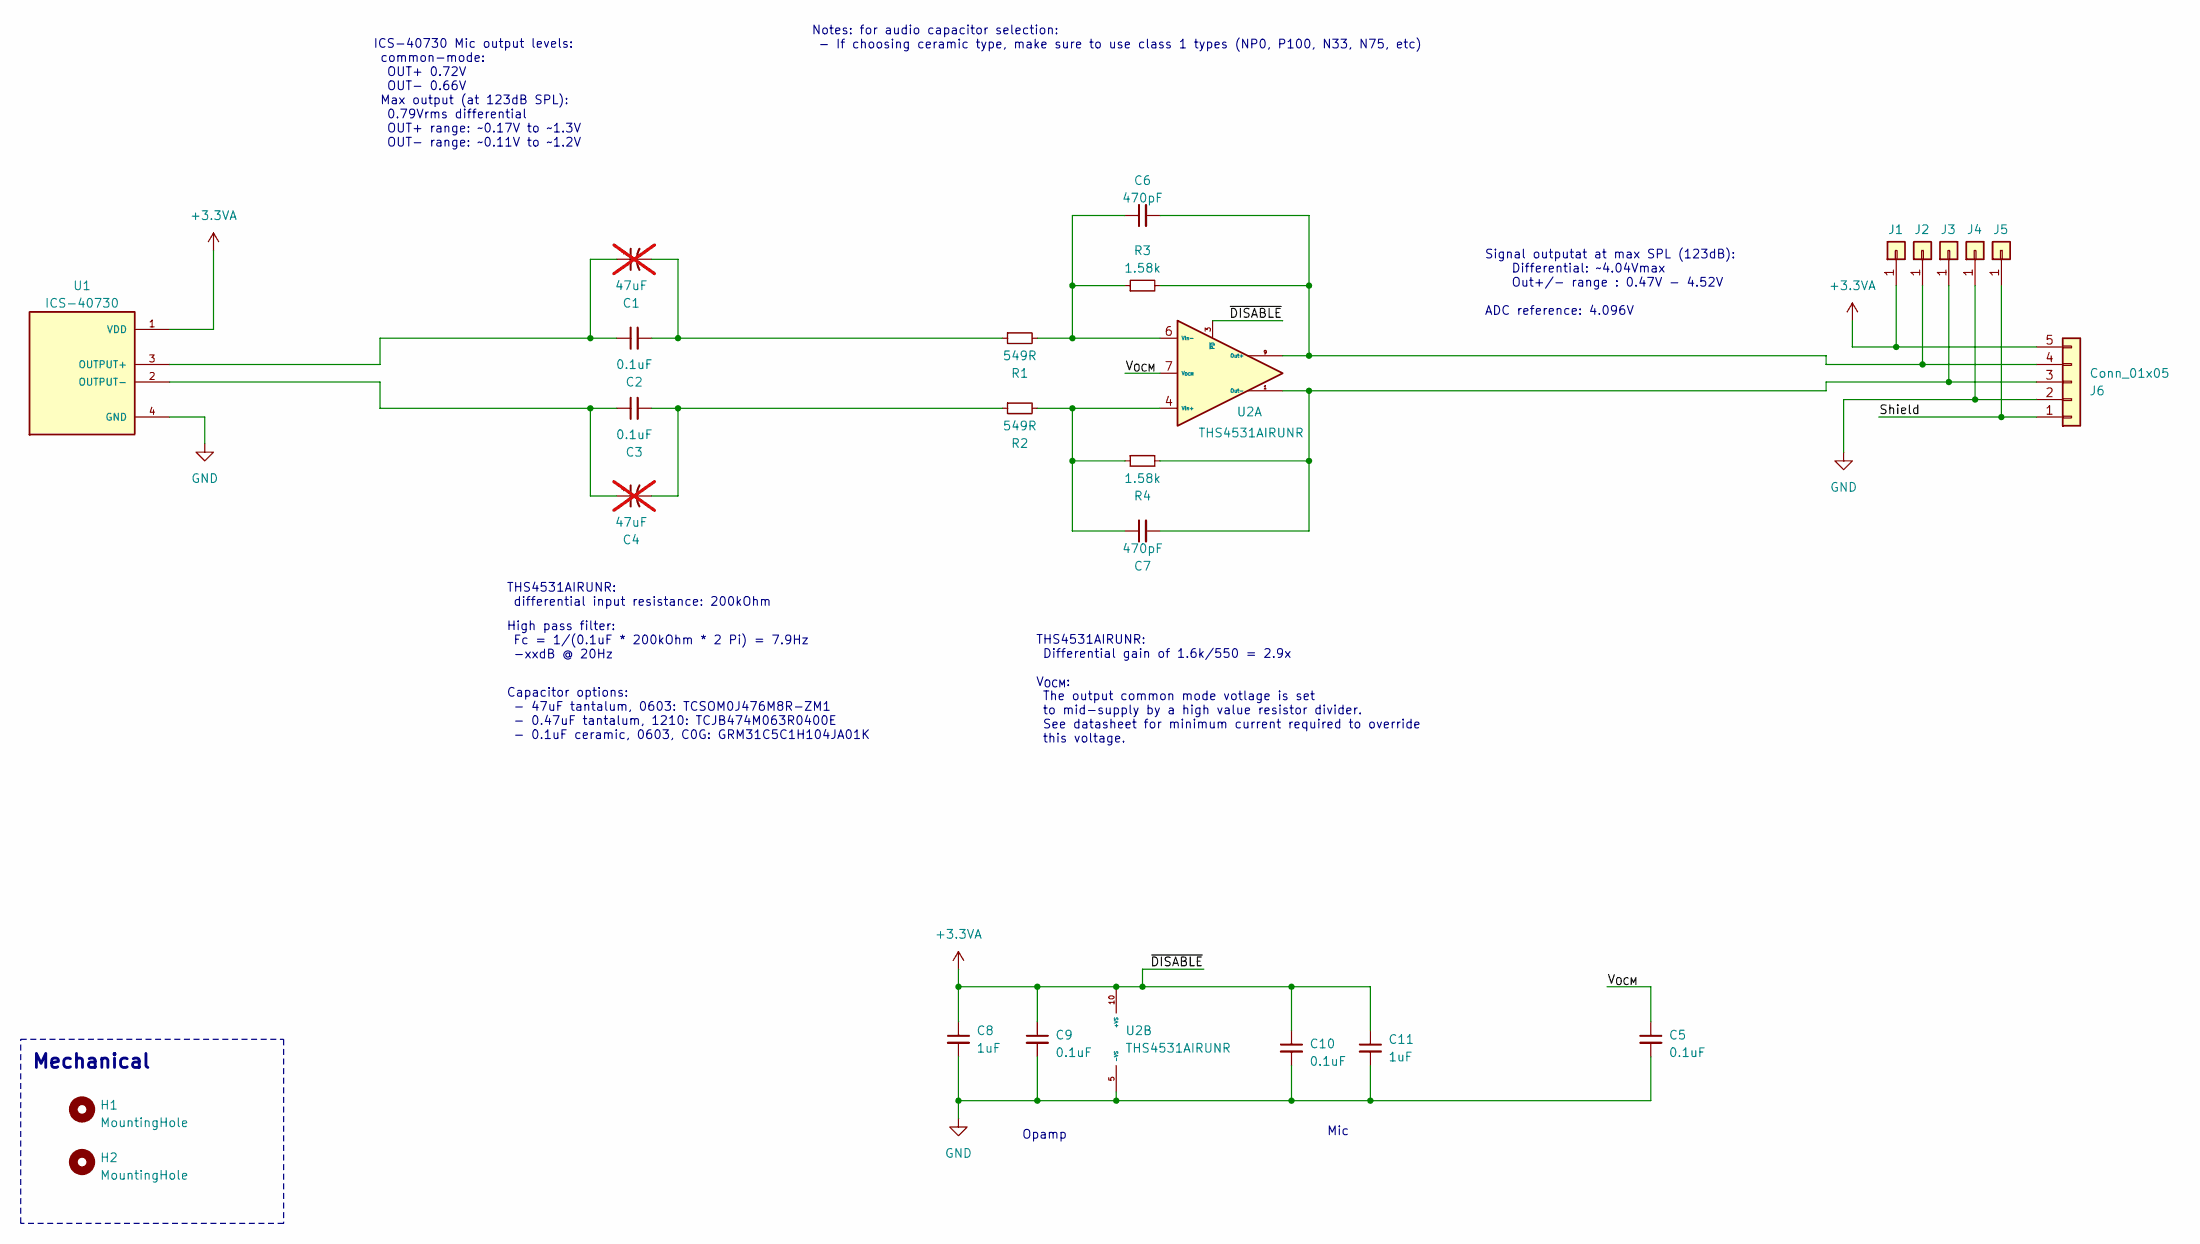
[picture p37: schematic mic-test-board_micboard.kicad_sch, Sound Compass POC: Mic Boards]

Parts:
C1, C4: 47uF; CP_EIA-1608-08_AVX-J; Part Number TCSOM0J476M8R-ZM1; not fitted
C2, C3: 0.1uF; C_1206_3216Metric; Voltage 50V; Part Number GRM31C5C1H104JA01K
C5, C9, C10: 0.1uF; C_0603_1608Metric; Part Number C0603C104K8RAC7867
C6, C7: 470pF; C_0603_1608Metric; Part Number 885012006027
C8, C11: 1uF; C_0603_1608Metric; Part Number CL10B105KP8NNNC
H1: MountingHole; MountingHole_3.2mm_M3; Part Number R30-1003002
H2: MountingHole; MountingHole_2.2mm_M2; Part Number R30-1003002
J1, J2, J3, J4, J5: Conn_01x01; TestPoint_THTPad_D2.0mm_Drill1.0mm
J6: Conn_01x05; Molex_PicoBlade_53047-0510_1x05_P1.25mm_Vertical; Part Number 0530470510
R1, R2: 549R; R_0603_1608Metric; Part Number RC0603FR-07549RL
R3, R4: 1.58k; R_0603_1608Metric; Part Number RC0603FR-071K58L
U1: ICS-40730; MIC_ICS-40730; Part Number ICS-40730
U2: THS4531AIRUNR; Texas_RUN0010A_WQFN-10_2x2mm_P0.5mm; Part Number THS4531AIRUNR

Connections:
+3.3VA: C8.1, C9.1, C10.1, C11.1, J1.1, J6.5, U1.1 (VDD), U2.3 (~PD), U2.10 (+VS)
/Shield: J5.1, J6.1
/V_{OCM}: C5.1, U2.7 (V_{OCM})
GND: C5.2, C8.2, C9.2, C10.2, C11.2, J4.1, J6.2, U1.4 (GND), U2.5 (-VS)
unnamed: C1.2, C2.2, R1.1
unnamed: C3.2, C4.2, R2.1
unnamed: C6.2, J2.1, J6.4, R3.2, U2.9 (Out+)
unnamed: C7.2, J3.1, J6.3, R4.2, U2.1 (Out-)
unnamed: C1.1, C2.1, U1.3 (OUTPUT+)
unnamed: C3.1, C4.1, U1.2 (OUTPUT-)
unnamed: C6.1, R1.2, R3.1, U2.6 (VIn-)
unnamed: C7.1, R2.2, R4.1, U2.4 (Vin+)

Notes on the sheet:
High pass filter: Fc = 1/(0.1uF * 200kOhm * 2 Pi) = 7.9Hz -xxdB @ 20Hz
THS4531AIRUNR: differential input resistance: 200kOhm
Notes: for audio capacitor selection: - If choosing ceramic type, make sure to use class 1 types (NP0, P100, N33, N75, etc)
THS4531AIRUNR: Differential gain of 1.6k/550 = 2.9x V_{OCM}: The output common mode votlage is set to mid-supply by a high value resistor divider. See datasheet for minimum current required to override this voltage.
Signal outputat at max SPL (123dB): Differential: ~4.04Vmax Out+/- range : 0.47V - 4.52V ADC reference: 4.096V
Mic
Opamp
ICS-40730 Mic output levels: common-mode: OUT+ 0.72V OUT- 0.66V Max output (at 123dB SPL): 0.79Vrms differential OUT+ range: ~0.17V to ~1.3V OUT- range: ~0.11V to ~1.2V
Mechanical
Capacitor options: - 47uF tantalum, 0603: TCSOM0J476M8R-ZM1 - 0.47uF tantalum, 1210: TCJB474M063R0400E - 0.1uF ceramic, 0603, C0G: GRM31C5C1H104JA01K

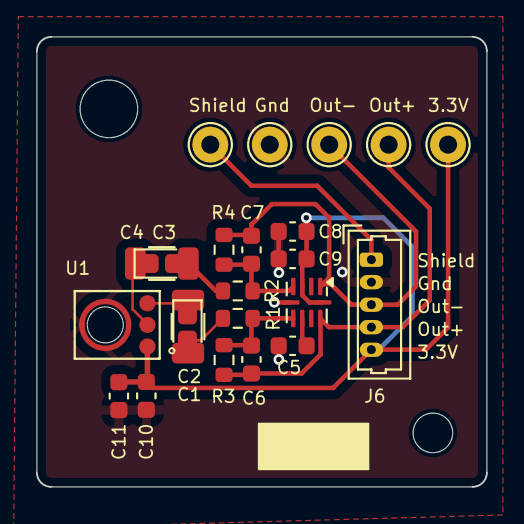
[picture p38: board mic-test-board_micboard.kicad_pcb from above]

Board: 2 copper layers, 25.0 x 25.0 mm, 25 parts (0 on the bottom side), 12 nets.
