jbrryhooves/sound-compass/src/firmware/sound-compass-mic-interface/sound-compass-mic-interface.ioc

Mcu.UserName=STM32H743ZITx
PA1.Signal=ETH_REF_CLK
PA12.Signal=USB_OTG_FS_DP
PA2.Signal=ETH_MDIO
PA4.GPIO_Label=GPIO_OUT_SPI1_nCS1
PA4.Signal=GPIO_Output
PA5.Signal=SPI1_SCK
PA6.Signal=SPI1_MISO
PA7.Signal=ETH_CRS_DV
PA9.Signal=USB_OTG_FS_VBUS
PB0.GPIO_Label=LD1 [Green Led]
PB0.Signal=GPIO_Output
PB13.Signal=ETH_TXD1
PB14.GPIO_Label=LD3 [Red Led]
PB14.Signal=GPIO_Output
PB15.Signal=USART1_RX
PB5.Signal=SPI1_MOSI
PB6.Signal=USART1_TX
PC0.GPIO_Label=GPIO_EXTI0_DRDY
PC0.Signal=GPXTI0
PC1.Signal=ETH_MDC
PC10.GPIO_Label=GPIO_EXTI1_PushButton1
PC10.Signal=GPXTI10
PC11.GPIO_Label=GPIO_EXTI1_PushButton2
PC11.Signal=GPXTI11
PC12.Signal=SPI3_MOSI
PC13.GPIO_Label=B1 [Blue PushButton]
PC13.Signal=GPIO_Input
PC4.Signal=ETH_RXD0
PC5.Signal=ETH_RXD1
PD0.GPIO_Label=GPIO_OUT_LED7
PD0.Signal=GPIO_Output
PD1.GPIO_Label=GPIO_OUT_LED8
PD1.Signal=GPIO_Output
PD10.GPIO_Label=USB_OTG_FS_PWR_EN
PD10.Signal=GPIO_Output
PD13.GPIO_Label=GPIO_OUT_SPI1_nCS2
PD13.Signal=GPIO_Output
PD5.Signal=GPIO_Output
PD8.GPIO_Label=STLINK_RX
PD8.Signal=USART3_TX
PD9.GPIO_Label=STLINK_TX
PD9.Signal=USART3_RX
PE1.GPIO_Label=LD2 [Yellow Led]
PE1.Signal=GPIO_Output
PE3.Signal=SAI1_SD_B
PE4.Signal=SAI1_FS_A
PE5.Signal=SAI1_SCK_A
PE6.Signal=SAI1_SD_A
PF8.Signal=SAI1_SCK_B
PF9.Signal=SAI1_FS_B
PG0.GPIO_Label=GPIO_OUT_LED5
PG0.Signal=GPIO_Output
PG1.GPIO_Label=GPIO_OUT_LED6
PG1.Signal=GPIO_Output
PG10.GPIO_Label=GPIO_OUT_LED4
PG10.Signal=GPIO_Output
PG11.Signal=ETH_TX_EN
PG12.GPIO_Label=GPIO_OUT_LED1
PG12.Signal=GPIO_Output
PG13.Signal=ETH_TXD0
PG15.GPIO_Label=GPIO_OUT_LED2
PG15.Signal=GPIO_Output
PG7.GPIO_Label=USB_OTG_FS_OVCR
PG7.Signal=GPXTI7
PG9.GPIO_Label=GPIO_OUT_LED3
PG9.Signal=GPIO_Output
