jbrryhooves/sound-compass/src/services/cppProcessor/audioProcessor/src/audioProcessor/app.cpp

#include <fmt/core.h>
#include <spdlog/spdlog.h>
#include <BS_thread_pool.hpp>

#include <chrono>
using namespace std::chrono;

#include <audioProcessor/app.hpp>


//clang-format off
static uint32_t  mic1 [audioProcessor::beamProcessor::BLOCK_SIZE] = {12181293, 13335284, 14360487, 15230209, 15921809, 16417279, 16703720, 16773674, 16625320, 16262521, 15694721, 14936705, 14008207, 12933401, 11740269, 10459876, 9125557, 7772051, 6434597, 5148017, 3945806, 2859265, 1916683, 1142599, 557167, 175630, 7920, 58404, 325768, 803050, 1477825, 2332524, 3344896, 4488582, 5733806, 7048150, 8397392, 9746406, 11060069, 12304180, 13446347, 14456835, 15309334, 15981650, 16456278, 16720862, 16768513, 16597991, 16213734, 15625748, 14849340, 13904725, 12816497, 11612986, 10325528, 8987641, 7634159, 6300318, 5020847, 3829057, 2755976, 1829543, 1073877, 508652, 148585, 3049, 75834, 365045, 863152, 1557187, 2429080, 3456131, 4611601, 5865406, 7184904, 8535741, 9882747, 11190852, 12426001, 13556034, 14551532, 15386576, 16039425, 16493083, 16735739, 16761074, 16568429, 16162819, 15554806, 14760218, 13799743, 12698388, 11484826, 10190653, 8849563, 7496472, 6166608, 4894594, 3713549, 2654220, 1744187, 1007145, 462281, 123781, 459, 95526, 406505, 925301, 1638407, 2527256, 3568708, 4735647, 5997693, 7321986, 8674050, 10018681, 11320874, 12546724, 13664315, 14644552, 15461914, 16095120, 16527684, 16748344, 16751356, 16536641, 16109790, 15481915, 14669363, 13693290, 12579107, 11355824, 10055288, 8711359, 7359028, 6033502, 4769292, 3599312, 2554023, 1660639, 942420, 418065, 101226, 152, 117473, 450137, 989481, 1721464, 2627028, 3682596, 4860688, 6130629, 7459358, 8812281, 10154173, 11450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
