jbrryhooves/sound-compass/(commit log)

2023-10-18 added some research scripts for generating Beam patterns, and 1/3 octave filter responses
    added C# program to generate microphone signals
2023-10-18 added start of firmware project. C++ blinky runs on dev board
2023-10-22 added first pass of diag class. Printf is not working yet
    [Diag.cpp, executiveMain.cpp]
2023-11-06 added ITimer, TimerFreeRTOS, and added timers to exec and audioprocessor
2023-11-20 feat: performance enhancements
    - increased clock speed from 64MHz to 480MHz
    - Moved working buffers of IIR filter bank to DTCM
    [Bitrates.xlsx]
2023-11-26 added generation of 1/3 ocatve bands, and hardcoded them in.
    added mic position calculation
    added steering delay calculation
    added signal summing with shifting
    loop time for 20ms of signal, with beam steering, and 1/3 octave band filtering for steered beam and the 'centre' mic is ~15ms
2023-11-28 turned optimisation to -O3 and the loop time dropped to 8ms (from 15ms) for 1 beam, 30 filters.
2023-12-07 added start of a c++ project to process the 1/3 octave filters. Using the KFR library, clang in release mode, it can do 30 x 4th order IIR filters over 960 samples, for each of the 50 angles in ~5ms 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
2023-12-16 added thread pool library.
2024-02-06 added start of ethernet based STM32 pathway.
    - TCP server is running
2024-02-06 removed old STM32 project
2024-02-12 firmware feat: SPI -> ethernet basics working
    - SPI data is being written and read via DMA at the required bit rate
    - message queues are setup and working to send TCP data when SPI data arrives
    - some more buffering/slack needs to be introduced to allow for jittery TCP consumers applying back pressure
    [Diag.cpp, LED.cpp, SPI.cpp]
2024-03-01 doc: committing current state of block diagram before pivot to analog mic + ADC architecture
2024-03-04 feat: commiting ICS-52000 based mic test board before pivot to analog mic + ADC's
    [IC-52000 Mic.kicad_sch, mic-test-pcb.kicad_pcb, mic-test-pcb.kicad_sch]
2024-03-14 feat: schematic WIP
    - Analog front end 99% selected and wired up
    - uController/dev board interface 1% done
    [ADCCommonParts.kicad_sch, ADC_AD7768.kicad_sch, AnalogFrontEnd.kicad_sch, IC-52000 Mic.kicad_sch, ICS-40730 Mic.kicad_sch, MicPreamp.kicad_sch, Power.kicad_sch, TestPCBCalcs.xlsx]
2024-04-10 pcb: commit before large routing effort
    - schematic refactor to split preamps to each mic board
    - Mic board and main board are placed
    - no tracks laid
    - critical parts selected
    [ADCCommonParts.kicad_sch, ADC_AD7768.kicad_sch, AnalogFrontEnd.kicad_sch, Anti-alias.kicad_sch, ICS-40730 Mic.kicad_sch, MicAndPreamp.kicad_sch, MicPreamp.kicad_sch, Power.kicad_sch]
2024-04-10 firmware: test code for streaming fake audio data over TCP
    [sound-compass-mic-interface.cfg]
2024-05-05 pcb: finished routing mic board and ADC board.
    - BOM complete
    - uController pinout configured with CubeMX and re-checked
    [ADCCommonParts.kicad_sch, ADC_AD7768.kicad_sch, AnalogFrontEnd.kicad_sch, Anti-alias.kicad_sch, Power.kicad_sch, mic-test-board_micboard.kicad_pcb, mic-test-board_micboard.kicad_sch, mic-test-pcb.kicad_pcb]
2024-05-08 pcb: ordered PCB's and BOM! RevA and v240506
    [ADCCommonParts.kicad_sch, ADC_AD7768.kicad_sch, AnalogFrontEnd.kicad_sch, Anti-alias.kicad_sch, BOM_mic-test-board_micboard_RevA.csv, Power.kicad_sch, mic-test-board_micboard.kicad_pcb, mic-test-board_micboard.kicad_sch]
2024-09-08 large updates: ADC pretty much working over SAI.
2024-09-13 firmware: sai working with one ADC, TCP server streaming (unconfirmed) data
2024-09-13 added python FIR based beamforming research and prototype
2025-03-21 sch: adding bringup notes
    [ADCCommonParts.kicad_sch, ADC_AD7768.kicad_sch, AnalogFrontEnd.kicad_sch, Anti-alias.kicad_sch, Power.kicad_sch, mic-test-board_micboard.kicad_sch, mic-test-pcb.kicad_sch, uController.kicad_sch]
2025-03-21 doc: added schematic and PCB pdf exports
