jbrryhooves/sound-compass/(notices)

Notices in the files:
src/firmware/sound-compass-mic-interface/Core/Src/spi.c:
Copyright (c) 2024 STMicroelectronics.
All rights reserved.
This software is licensed under terms that can be found in the LICENSE file
src/firmware/sound-compass-mic-interface/Core/Inc/main.h:
Copyright (c) 2022 STMicroelectronics.
